fcastel2002/esc-bldc-sensorless-stm32/INFORME/README.md

# Informe y proyecto Overleaf

Esta carpeta contiene la documentacion tecnica del ESC BLDC sensorless con STM32.

## Archivos principales

- Paper/informe final en PDF: [ESC_Bldc___paper_congreso_utn___en_revision.pdf](ESC_Bldc___paper_congreso_utn___en_revision.pdf)
- Proyecto LaTeX/Overleaf: [ESC_Bldc___paper_congreso_utn___en_revision/](ESC_Bldc___paper_congreso_utn___en_revision/)
- Esquematico de deteccion ZC: [esquematico_zc.pdf](esquematico_zc.pdf)
- Esquematico alternativo ZC: [esquematico_2zc.pdf](esquematico_2zc.pdf)

## Imagenes destacadas

Maqueta final del prototipo

Diagrama conceptual

Circuito de cruces por cero
