fcastel2002/esc-bldc-sensorless-stm32/specs/templates/spec.md

# NNN Feature Name

Status: Draft

## Problem

Describe the user or system problem.

## Objective

Describe the outcome this feature must produce.

## Scope

In scope:

- Item 1.

Out of scope:

- Item 1.

## Affected Subprojects

- Firmware: Yes/No
- GUI/Bridge: Yes/No
- Protocol: Yes/No
- PIL/HIL/Simulink: Yes/No
- Docs/CI: Yes/No

## Protocol Impact

State whether frame layout, opcodes, constants, config semantics, telemetry, HID, UART, or UDP behavior changes.

## Acceptance Criteria

- Criterion 1.

## References

- Link to related docs, issues, or decisions.
