fcastel2002/esc-bldc-sensorless-stm32/INFORME/ESC_Bldc___paper_congreso_utn___en_revision.pdf

# Desarrollo de ESC para motores BLDC sin sensores de posicion, basado en ´ microcontrolador de la gama STM32

Francisco Castel
Facultad de Ingeniería - UNCUYO Mendoza, Argentina
castel.francisco@uncuyo.edu.ar https://github.com/fcastel2002

Abstract—Este trabajo presenta el desarrollo e
implementacion de un Controlador Electr ´ | onico de Ve- ´
locidad (ESC) sensorless para motores BLDC/PMSM utilizando microcontroladores STM32. El diseno se ˜ centra en un enfoque de bajo costo y complejidad reducida, basado en la deteccion de cruces por ´ cero (ZCP) de la fuerza contraelectromotriz mediante comparadores analogicos, complementado con ´ un control PI para la regulacion de velocidad. La ´ arquitectura propuesta aprovecha perifericos nativos ´ del STM32F103C8T6 (timers avanzados, ADC, UART y memoria Flash), lo que minimiza la carga computacional y aumenta la robustez del sistema. Se implemento una estrategia de arranque basada en ´
modulacion SPWM trif ´ | asica en lazo abierto, que ase- ´
gura una transicion estable hacia el r ´ | egimen ´ | sensor-
less. Asimismo, se desarrollo una m ´ | aquina de estados ´
modular que gestiona los distintos modos de operacion´ (IDLE, RUNNING, CLOSED-LOOP, CONFIG, entre otros), mejorando la escalabilidad y confiabilidad del firmware. Los ensayos experimentales con motores BLDC extraídos de discos rígidos demostraron un rango de operacion entre 100 y 5500 rpm, esta- ´ bilidad termica en la etapa de potencia basada en ´ L298N, y un control adecuado bajo condiciones de carga predecible. El prototipo constituye una base funcional para aplicaciones donde la simplicidad y la eficiencia prevalecen sobre la necesidad de control dinamico avanzado, tales como ventiladores, sistemas ´
de bombeo y pequenos veh ˜ | ículos electricos. Final- ´
mente, se discuten limitaciones del enfoque reactivo y posibles mejoras mediante tecnicas predictivas o ´ híbridas, apuntando hacia futuras implementaciones con mayor robustez e integracion industrial. ´
I. INTRODUCCION´

Los motores BLDC-PMSM (Brushless DC - Permanent Magnet Synchronous Motors) representan una tecnología fundamental en aplicaciones que requieren alta eficiencia y control preciso, desde
electrodomesticos hasta veh ´ | | ículos electricos y sis- ´
temas industriales. Su alta densidad de potencia, eficiencia superior (típicamente 85-95%) y mayor vida util los han convertido en la pieza fundamental ´ durante el desarrollo y evolucion de los drones, ´
donde la relacion potencia-peso es cr ´ | | ítica. Es por
esto que la motivacion principal de este trabajo es ´ la de entender profundamente el funcionamiento de este tipo de motores y las estrategias y tecnicas de ´ control del mismo.
Para lograr este objetivo se propuso la realizacion´ de un Controlador Electronico de Velocidad (ESC) ´ ya que prometía ser un desafio interesante y con ´ cierta complejidad.
La evolucion de las t ´ | ecnicas ´ | sensorless ha sido
notable desde que Iizuka et al. [1] propusieron
en 1985 un metodo basado en la detecci ´ | | on del ´
Zero Crossing Point (ZCP) mediante comparadores externos, estableciendo las bases para futuros desarrollos. Posteriormente, tecnicas como las descritas ´
por [2] mejoraron la precision mediante la medici ´ | on´
de BEMF durante la ventana de PWM OFF. Un avance significativo llego con Chen [3], quien ´ simplifico el ´ hardware necesario aprovechando el voltaje de línea, eliminando la necesidad de cir-

cuitos analogicos adicionales para el c ´ | alculo del ´
instante de conmutacion. ´
Actualmente, el Control de Campo Orientado (FOC) representa el estado del arte, ofreciendo control preciso de par y velocidad en un amplio rango operativo. Sin embargo, el FOC requiere algoritmos complejos que demandan mayor capacidad computacional y una medicion de corriente con ´ SNR superior a 40dB, lo que incrementa los costos de implementacion. ´
El objetivo del presente trabajo es proporcionar
un metodo sencillo y econ ´ | omico para el control ´
sensorless de motores BLDC/PMSM utilizando microcontroladores STM32. El enfoque se basa en la deteccion de cruces por cero mediante circuitos ´ analogicos simples, complementados con un control ´ PI para regular la velocidad. Esta implementacion´ aprovecha los perifericos del STM32F103C8T6 ´ (ADC, timer avanzados, etc) para minimizar la carga computacional, resultando ideal para aplicaciones de ventilacion y movimiento de aire donde ´ no se requiere control de posicion ni alto par de ´ arranque. El metodo es aplicable en sistemas de ´ baja y media potencia con velocidades mínimas de operacion superiores al 15-20% de la nominal. ´ Este documento esta organizado en secciones ´
que cubren: fundamentos teoricos del control ´ | sen-
sorless, diseno del hardware basado en STM32, ˜
implementacion del algoritmo de detecci ´ | on y con- ´
trol, resultados experimentales, y conclusiones con recomendaciones para trabajos futuros.
A. Principio de funcionamiento de motores BLDC
- PMSM

Cuando hablamos de motores sin escobillas, existen principalmente dos tipos, los motores con una BEMF trapezoidal, categorizados como BLDC, y los que presentan una BEMF sinusoidal, como PMSM. Ambos difieren de los motores DC con escobillas en que la conmutacion debe realizarse ´ de forma electronica, y no se realiza por la con- ´ struccion del mismo. Esta diferencia en la forma ´ de onda de la BEMF se debe principalmente a la
distribucion del bobinado y la configuraci ´ | on del ´
campo magnetico del rotor: los ´ | BLDC típicamente
utilizan bobinados concentrados y magnetizacion´ radial, mientras que los PMSM emplean bobinados distribuidos y, en muchos casos, magnetizacion´ sinusoidal.


Figure 1. Diferencia sustancial entre BLDC y PMSM

1) Metodos de detecci ´ | on de cruces por cero: ´ | La
deteccion de los cruces por cero (ZCP) de la ´ | | BEMF
constituye el metodo m ´ | as implementado para el ´
control sensorless de motores BLDC. Este punto ocurre cuando la BEMF cambia de polaridad, lo
que corresponde a una posicion espec ´ | ífica del rotor,
generalmente desfasada 30° electricos del punto ´
optimo de conmutaci ´ | on. ´
a) Deteccion directa de BEMF: ´ | | El metodo ´
clasico propuesto por Iizuka et al. [1] utiliza com- ´ paradores analogicos para detectar el instante en que ´ la BEMF cruza el nivel de referencia (generalmente el punto neutro virtual). Esta tecnica requiere cir- ´ cuitería de acondicionamiento para:
- Filtrar el ruido de conmutacion´
- Crear un punto neutro virtual para comparacion´
- Generar una senal de interrupci ˜ | on al microcon- ´
trolador
Mas adelante en el presente trabajo, se expresa la
eleccion de este m ´ | etodo. ´
b) Metodo de integraci ´ | on de la tercera ´
armonica: ´ | Esta tecnica, desarrollada por Moreira ´
en el 96’ [2], aprovecha el hecho de que la suma de las tres BEMF contiene una tercera armonica ´ significativa. La integracion de esta componente ´
proporciona informacion de posici ´ | on m ´ | as robusta ´
frente al ruido, aunque requiere un procesamiento adicional.

c) Metodo de terminal ´ | unico: ´ | Propuesto por
Chen et al. [3], este enfoque simplifica la implementacion hardware al utilizar solo un terminal ´
para la medicion de voltaje de l ´ | | ínea. La principal
ventaja es la reduccion de componentes externos y ´ la posibilidad de implementacion completa en mi- ´ crocontroladores con suficientes recursos de ADC.
d) Deteccion mediante PWM sincronizado: ´ Este metodo, particularmente adecuado para im- ´ plementaciones en microcontroladores, muestrea la BEMF durante los períodos de apagado del PWM, cuando la corriente de fase es mínima. La tecnica ´ requiere una sincronizacion precisa entre el PWM y ´ la secuencia de muestreo del ADC, factible en microcontroladores avanzados como la familia STM32 que ofrecen disparo sincronizado entre perifericos ´ [4].

II. ESQUEMA TECNOLOGICO ´

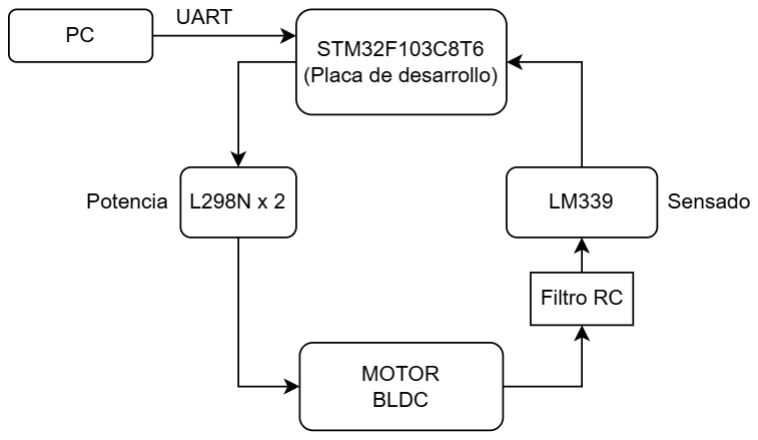
[picture p19: figure]

A. Detalle de modulos ´
1) Etapa de potencia: L298N: La etapa de po-
tencia se implemento utilizando dos m ´ | odulos basa- ´
dos en el circuito integrado L298N [5], configurados para proporcionar tres medios puentes H necesarios para la conmutacion trif ´ asica del motor ´ BLDC. Cada medio puente se controla mediante dos senales: una para el transistor superior y otra ˜ para el inferior. Este modulo presenta las siguientes ´ características:
- Voltaje de salida: 5V - 35V
- Voltaje logico: 5V - 7V ´
- Corriente maxima por canal: 2A ´
- Potencia maxima de disipaci ´ | on: 25W ´


Figure 2. Modulo comercial basado en L298N y sus respectivas ´ etapas de filtrado y feedback.

2) Motor utilizado: Para las pruebas se utilizaron dos motores sin escobillas sacados de discos rígidos antiguos, estos fueron una gran eleccion debido ´ a la alta disponibilidad como chatarra. No fue posible probar el sistema con motores BLDC de alto rendimiento como los presentes en drones comerciales. Así como estos motores son sencillos de conseguir, tambien es muy dificil de encontrar alguna referencia de ellos en internet ya que la
mayoria de codigos de referencia y/o n ´ | umeros, eran ´
mas bien codigos internos y no existen como tales, ´ por lo que no se consiguieron datos del motor como tal. Aunque un parametro que si era relevante para ´ saber si el algoritmo estaba funcionando de una forma adecuada era la velocidad maxima, y la de ´ los discos rígidos antiguos solía ser de no mas de ´ 5400 rpm, a diferencia de los actuales que llegan a las 7200 rpm.
Para que se nocion de la antig ´ | uedad de estos mo- ¨
tores, los discos duros de los que fueron extraídos usaban motores paso a paso para mover la aguja de lectura.


Figure 3. Motor extraido de un disco rígido antiguo

3) Circuito externo de deteccion: ´ Para la deteccion de cruces por cero de la fuerza ´ contraelectromotriz (BEMF), se implemento el ´ metodo propuesto por Iizuka [1], que utiliza ´
comparadores | analogicos | para | detectar | los ´
instantes en que la BEMF de la fase flotante cruza el nivel del punto neutro virtual. La fig:zerocrossing2muestraelcircuitoimplementado. En esta configuracion, las resistencias R4-R6 (10 ´ kΩ) crean un punto neutro virtual, lo que flexibiliza el tipo de bobinado de motor, ya que sea Estrella o Delta (acceso al neutro real o no) se utilizan solo las terminales de las tres fases. Luego las resistencias R1-R3 (10kΩ) y capacitores C1, C2 y C3 (47 nF) forman una etapa de filtrado para reducir el ruido de conmutacion y propio del motor. Los comparadores ´ del LM339 [6] detectan el momento exacto del cruce por cero (aun así se dota de histeresis me- ´ diante resistencias de 100 kΩ), generando flancos que son capturados por los canales de Input Capture (IC CH1, IC CH2 e IC CH3) del temporizador del microcontrolador.
Se selecciono el LM339 debido a su salida de ´ colector abierto, que permite una interfaz segura entre los 12V del circuito de potencia y los 3.3V del STM32F103C8T6, sin necesidad de circuitos adicionales de adaptacion de nivel. ´


Figure 4. Circuito implementado

Se decide la utilizacion de un comparador de ´ collector abierto como el LM339 [6] debido a su versatilidad al momento de interactuar con dispositivos de voltajes sumamente distintos al de alimentacion, como en este caso, 12V contra los ´ 3.3 V del STM32F103C8T6.

III. FUNCIONAMIENTO GENERAL

El objetivo principal del controlador es el de lograr la consigna de velocidad en el motor, para ello debe recibir los cruces por cero y a partir de ellos realizar las conmutaciones correspondientes. El funcionamiento del firmware en sí es sencillo, lo que hace es:
1) Rutina de arranque.
2) Realizar la conmutacion cuando se recibe el ´ flanco correspondiente desde el circuito comparador.
3) Medir el periodo entre dos flancos de subidas de una misma fase.
4) Cada cierto tiempo (regido por la velocidad maxima) actualizar la salida PWM mediante ´ un control PI.

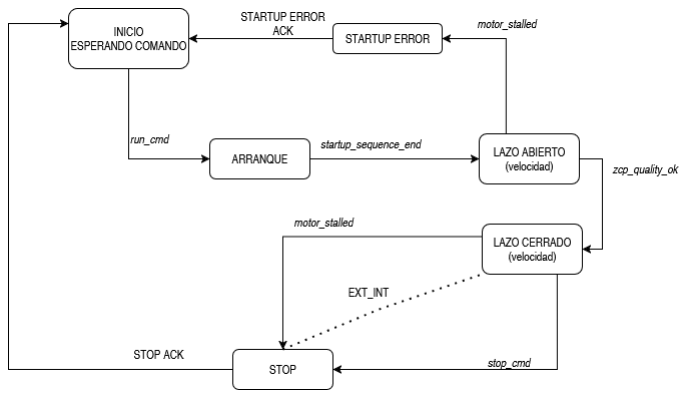
[picture p20: figure]

Pero esto no es suficiente para una conmutacion´ robusta, fue sumamente necesario incluir un algoritmo sencillo de deteccion de la consistencia de la ´ senal del cruce por cero. Esto es crucial para sobre ˜ todo el funcionamiento en lazo cerrado.

IV. PROGRAMACION´

A. Configuracion de perif ´ | ericos del microcontro- ´
lador
El microcontrolador STM32F103C8T6 se con-
figuro para realizar tanto la detecci ´ | on de cruces por ´

cero como la generacion de se ´ | nales de control para ˜
los puentes H:
- timer 2: Configurado con tres canales en modo Input Capture para detectar los flancos provenientes de los comparadores. Este enfoque, en lugar de utilizar interrupciones externas (EXTI), permite medir directamente el período entre cruces por cero, facilitando el calculo ´ de la velocidad del motor y la temporizacion´ precisa de la conmutacion. ´
- timer 1: Utilizado como generador PWM para controlar los transistores superiores de los medios puentes. Se configuro para operar en un ´ rango de frecuencias entre 10 y 24 kHz (no fue necesaria la implementacion de tiempo muerto ´ dado que el retraso propio de la conmutacion´ proporciona una especie de dead time).
- UART1: Periferico UART configurado a ´ 115200 de baudrate utilizado en modo interrupcion. ´
- CRC: Periferico utilizado para la verificaci ´ | on´
de integridad de datos. Este modulo permite ´
realizar calculos r ´ | apidos de verificaci ´ | on, con- ´
tribuyendo a la robustez en la transmision´
y almacenamiento de parametros cr ´ | íticos, se
utiliza para la persistencia de parametros en ´ FLASH.
- Memoria Flash: Utilizada para almace-
namiento no volatil de par ´ | | ametros de config- ´
uracion y calibraci ´ | on del ESC. La memoria ´
Flash permite conservar configuraciones esenciales entre reinicios o ciclos de alimentacion. ´ Permite al operario configurar su ESC como desee.
1) Senales PWM: ˜ | La tecnica PWM seleccionada ´
corresponde a ”PWM technique 1” en la fig:pwmtech, tambien conocida como PWM unipolar. En ´ esta configuracion, durante cada sector de 60° ´ electricos, una fase se conecta al positivo mediante ´ PWM, otra fase se conecta al negativo de forma permanente, y la tercera fase permanece flotante
(desconectada). Se eligio esta t ´ | ecnica ya que la ´
implementacion de las dem ´ | as t ´ | ecnicas, seg ´ | un Lai ´
et al en [7], pueden cobrar sentido si se utiliza un metodo de sensado directo de la BEMF mediante ´ ADC.

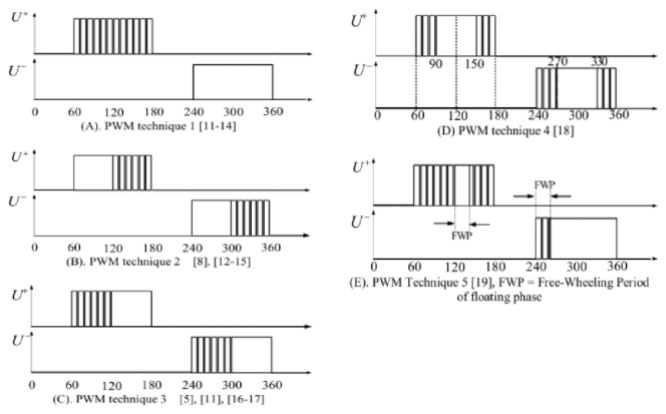
[picture p21: figure]

Figure 5. Resumen de tecnicas PWM para motores BLDCM. ´ [7]

B. Estrategia de arranque
El arranque representa uno de los mayores desafíos en el control sensorless de motores BLDC, ya que a velocidad cero o muy baja no se genera suficiente BEMF para detectar la posicion del rotor. ´ En este trabajo se evaluaron diferentes estrategias de arranque antes de seleccionar la implementacion´ final.
1) Alternativas consideradas: La tecnica ´ | Align
& Go, ampliamente documentada en la literatura, fue inicialmente considerada debido a su simplici-
dad de implementacion. Sin embargo, esta t ´ | | ecnica ´
presenta una desventaja significativa: la posibilidad de que el rotor inicie su movimiento en direccion´ opuesta a la deseada. Si bien existen algoritmos para detectar y corregir esta situacion, su imple- ´
mentacion requiere una detecci ´ | on casi instant ´ | anea ´
del sentido de rotacion y una r ´ | apida inversi ´ | on de ´
la secuencia de conmutacion, aumentando consid- ´ erablemente la complejidad del sistema.
Otra alternativa analizada fue el metodo IPD ´ (Initial Position Detection), implementado por Meghana et al en [8], que permite un arranque desde velocidad cero mediante la deteccion de la ´
posicion inicial del rotor. A pesar de ser el m ´ | | etodo ´
mas utilizado en aplicaciones comerciales de con- ´ trol sensorless, la complejidad de sus algoritmos y los requisitos de sincronizacion precisa entre ´ perifericos lo situaron fuera del alcance de este ´ trabajo.
2) Solucion implementada: SPWM en la etapa ´ de arranque: La estrategia de arranque adoptada se basa en un generador senoidal de tres fases mediante modulacion por ancho de pulso senoidal ´ (SPWM), implementado completamente en lazo abierto. Esta tecnica consiste en: ´
1) Precalculo de tres tablas senoidales desfasadas ´
120° electricos entre s ´ | í (una por fase), ajus-
tadas al formato Q15 y escaladas para facilitar su modulacion en tiempo real. ´
2) Generacion peri ´ odica de valores PWM actual- ´ izados a partir de dichas tablas, mediante un temporizador auxiliar que actualiza el índice de fase a intervalos controlados.
3) Aplicacion de estas se ´ | nales al puente inversor ˜
trifasico del motor, con habilitaci ´ | on de las tres ´
fases y control de flotacion durante toda la ´ etapa de arranque.
4) Incremento controlado de la frecuencia efec-
tiva del campo rotante a traves de la reducci ´ | on´
progresiva del ARR (Auto-Reload Register) del temporizador auxiliar.
5) Aumento gradual del valor de modulacion´ (mod_q15), que controla la amplitud de la senal aplicada, desde un valor inicial bajo ˜ (≈ 20%) hasta una amplitud estable cercana al 100%.
6) Finalizacion | autom ´ | atica | del | arranque ´
tras | un | numero | fijo | de | iteraciones ´
(STARTUP_ITERATIONS), | momento | en
el cual se realiza la transicion controlada al ´
modo de conmutacion trapezoidal ´ | sensorless.

La logica de control se implementa utilizando el ´ temporizador TIM4 del STM32F103C8T6 para las actualizaciones periodicas de PWM, mientras que ´ el generador de PWM (TIM1) continua modulando la senal SPWM. Durante el arranque, el sistema no ˜ requiere retroalimentacion alguna del motor: no se ´
evalua la ´ | BEMF, ni se mide corriente, ni se utiliza
informacion de posici ´ | | on. ´
La transicion al modo de operaci ´ | on´ sensorless
se realiza de forma determinista, tras agotar el tiempo definido para el arranque. En ese instante, se detiene la modulacion SPWM, se deshabilitan mo- ´ mentaneamente las salidas, y se reinicializa el sis- ´ tema para comenzar con la conmutacion trapezoidal ´ convencional, habilitando el sistema de deteccion de ´ cruces por cero.
3) Ventajas y limitaciones: Esta aproximacion´ presenta varias ventajas relevantes para la aplicacion: ´
- Permite un arranque suave y robusto, incluso
en ausencia total de informacion de posici ´ | on o ´
velocidad.
- Es insensible a la posicion inicial del rotor, ´ gracias a la naturaleza continua del campo magnetico rotante generado. ´
- Su implementacion es simple y determinista: ´ no requiere ajustes dinamicos durante el ar- ´
ranque, ni evaluacion de condiciones de ´ | exito ´
o fallo.
Como limitacion principal, el sistema no es capaz ´ de detectar si el motor ha sincronizado efectivamente durante la etapa de arranque. El metodo ´ asume que, al finalizar el tiempo definido, el rotor
habra sido capaz de seguir el campo magn ´ | etico ´
generado. Esto representa un riesgo en condiciones de carga elevada o con el rotor bloqueado, ya que la transicion podr ´ ía realizarse sin que el motor haya adquirido velocidad efectiva.
Cabe destacar, sin embargo, que si bien durante el arranque no se evalua la consistencia de los cruces ´
por cero debido a que la senal de ˜ | BEMF queda
enmascarada por la modulacion senoidal (haciendo ´ que cualquier cruce detectado en esta etapa sea irrelevante o espurio), el sistema implementa una verificacion posterior. Tras completarse el tiempo de ´ arranque y al entrar al modo sensorless, si los cruces por cero detectados no presentan la coherencia esperada, se considera fallida la sincronizacion y ´ se vuelve automaticamente a ejecutar la maniobra ´ de arranque desde cero. Esta estrategia anade una ˜ capa de robustez frente a condiciones anomalas sin ´ complejizar la logica de control durante el arranque ´ propiamente dicho.
C. Conmutacion´
Para conmutacion de las fases, se optan dos es- ´ trategias cruciales para no perder la sincronizacion´ tan buscada desde la etapa de arranque entre los cruces por cero, la posicion del rotor y los pasos de ´ la conmutacion. ´
1) Fase flotante como variable global: Un problema que surgía al momento de utilizar el metodo ´

de Iizuka es que si no se asignaba un orden de prioridad a las interrupciones era factible que uno de los canales detectara una segunda interrupcion´ antes de que el canal de la fase que nos interesa (la fase flotante) detectase su flanco, provocando esto una conmutacion a destiempo. Por esto se deciden ´ crear tres variables booleanas (float U; float V y float W) que se encargan de informar al callbak de interrupciones de cual sera la pr ´ oxima fase flotante, ´ es decir, el proximo canal que debe atender. Por ´ ejemplo, para el paso de conmutacion que energiza ´ las fases U y V (+U -V) el trio de variables tomaría los siguientes valores:
- float U = false
- float V = false
- float W = true
Agregando así un condicional adicional al callback de interrupcion. ´
2) Alternado de polaridad del input capture: Un factor indispensable a tener en cuenta durante el desarrollo de la conmutacion fue el de la necesidad ´ de que los canales del input capture correspondientes a cada fase pudiesen captar tanto flancos de bajada como de subida, lamentablemente esto no esta permitido para el canal 3 del timer 1 (aun siendo este un timer avanzado) por lo que este inconveniente se soluciono cambiando la polaridad de cada canal de forma alternada, es decir que, por ejemplo, el canal que corresponde a la fase U, para la primer posicion dentro de la secuencia se establece con polaridad de flanco de bajada, y luego para el proximo paso donde la fase U es flotante, se establece la polaridad de flanco de subida, esto
se repetira para cada canal. Esta implementaci ´ | on no ´
solo soluciono las incapacidades del ´ | timer 1, si no
que propuso mas robustez al sistema previniendolo ´ de falsos cruces por cero dados por posible ruido, así, es imposible que un flanco de bajada sea detectado previo a otro flanco de bajada del mismo canal.
D. Sistema de maquina de estados ´

La maquina de estados constituye la columna ver- ´ tebral del controlador, gestionando las transiciones entre los diferentes modos de operacion. ´

Table I
SECUENCIA DE CONMUTACION DE ´ | 6 PASOS PARA MOTOR
BLDC
2*Paso | Enable | PWM | 2*Polaridad | Flotantes
| U V W | U V W | | U V W
POS UV POS UW POS VW POS VU POS WU POS WV | 1 1 0 1 0 1 0 1 1 1 1 0 1 0 1 0 1 1 | PWM 0 -PWM -0 -PWM 0 0 PWM -0 -PWM -0 PWM | Fall(CH1) Rise(CH3) Fall(CH2) Rise(CH1) Fall(CH3) Rise(CH2) | No No Sí No Sí No Sí No No No No Sí No Sí No Sí No No
La funcion´ | handleState() implementa un
patron de dise ´ | no basado en estados que permite: ˜
- Separar claramente la logica para cada modo ´
| de operacion´
- Gestionar transiciones controladas entre esta-
| dos
- Mantener activas solo las interrupciones necesarias en cada estado
V. RESUMEN DEL FUNCIONAMIENTO DE LA
| MAQUINA DE ESTADOS ´
El | modulo | de | la | m ´ | aquina | de | estados ´
(‘state machine.c‘) | implementa | el | control
centralizado del ESC mediante una estructura clara y robusta basada en estados. Las funciones y características principales son:
- handleState(): Gestiona la transicion entre es- ´ tados, procesando eventos internos y externos, asegurando una ejecucion ordenada y segura ´
| del ESC.
- Estados clave:
– IDLE: Estado inicial o de espera sin actividad del motor.
– PROCESS COMMAND: Procesa comandos recibidos desde el modulo de comuni- ´
| cacion. ´
– FOC STARTUP: Maneja la secuencia inicial de arranque.
– RUNNING: Estado operativo basico, ges- ´ tionando velocidad abierta.
– CLOSEDLOOP: Control operativo avanzado con ajuste automatico por reali- ´
| mentacion. ´
– CONFIG: | Realiza | configuraciones
recibidas por comandos externos.

– READY: Preparacion intermedia para el ´ control de lazo cerrado.
– STOPPED: Estado de detencion del motor. ´ – FINISH: Finaliza operaciones y retorna a IDLE.
– HARD ERROR: | Manejo | de | errores
críticos que requieren intervencion. ´
La maquina de estados garantiza un control ro- ´ busto, previniendo errores críticos mediante transi-
ciones claras y supervisadas, y actua como n ´ | ucleo ´
central que coordina la interaccion y comunicaci ´ | on´
efectiva entre todos los modulos del sistema. Su ´ estructura es facilmente escalable, facilitando la ´
incorporacion de nuevos estados y eventos seg ´ | | | un´
sea necesario.
A. Funciones mas importantes del control
- commutation()
Controla | la | secuencia | de | acti-
vacion/desactivaci ´ | on de las fases U, V, y ´
W del motor brushless segun el paso actual ´ de conmutacion. ´
Establece las polaridades adecuadas y asigna valores PWM específicos a cada fase segun la ´ posicion del rotor. ´
- zero crossing()
Gestiona el control del motor mediante la
deteccion de cruces por cero ( ´ | Zero Crossing
Points - ZCP).
Realiza la conmutacion del motor en cada ´ cruce por cero detectado en cualquiera de las fases.
Actualiza la velocidad usando mediciones trifase para calcular un promedio por consenso entre las fases (metodo robusto). ´
- pi control()
Implementa un controlador Proporcional-Integral (PI) para ajustar el PWM del motor segun un setpoint de velocidad. ´
Utiliza parametros configurables (KP, KI) para ´ el control fino de la velocidad y limita la salida PWM dentro de rangos seguros.
- check motor status()
Monitorea periodicamente el estado operativo ´ del motor.

Detecta condiciones de bloqueo (stall) mediante la comprobacion de tiempo desde el ´
ultimo cruce por cero v ´ | alido. Establece una ´
bandera (motor stalled) para indicar situaciones críticas.
- stop motor()
Maneja el procedimiento para detener el motor en dos modos:
Detencion gradual (modo normal). ´
Detencion inmediata de emergencia (modo ´ crítico), con cambio de direccion temporal para ´ frenado rapido. ´
- calculate consensus speed()
Calcula la velocidad promedio por consenso utilizando mediciones consistentes de multiples fases, lo que mejora significativa- ´ mente la robustez ante ruidos o fallos ocasionales en la deteccion de cruces por cero. ´
B. Sistema de comunicacion´

El controlador implementa un protocolo de co-
municacion basado en comandos textuales a trav ´ | es´
de UART, permitiendo la configuracion y monitor- ´ izacion del sistema. ´
1) Resumen del funcionamiento de la comuni-
cacion: ´ | El modulo de comunicaci ´ | on (‘comm.c‘) ´
implementa la interfaz UART para interaccion ex- ´ terna con el ESC. Las funciones mas importantes ´ son:
- commInit(): Inicializa el buffer de recepcion y ´
comienza la recepcion por interrupci ´ | on usando ´
UART.
- processUartData(): Lee y procesa bytes recibidos del buffer circular. Detecta comandos completos al recibir caracteres finales como \r
o \n, almacenandolos para su ejecuci ´ | on. ´
- processCommand(): | Analiza | comandos
recibidos, | los | valida | sintacticamente | y ´
determina la accion a realizar, pudiendo ´
ejecutar | acciones | como | RUN, | STOP,
EMERGENCY STOP o ajustes específicos como la frecuencia PWM.
- executeCommand(): Ejecuta la accion indi- ´ cada en el comando analizado (por ejemplo, configurar la frecuencia PWM o iniciar la maniobra de arranque FOC), devolviendo un estado de confirmacion. ´
- transmitirUART(): Envía respuestas por UART usando transmisiones no bloqueantes por interrupcion, informando estados o errores ´ al usuario externo.
Este modulo asegura una comunicaci ´ | on robusta ´
y eficiente con la interfaz externa, permitiendo el control dinamico del ESC mediante comandos ´
estructurados. Ademas, su dise ´ | no es altamente es- ˜
calable, ya que permite facilmente la incorporaci ´ | on´
de nuevas acciones y parametros para extender o ´ adaptar el conjunto de comandos disponibles.

VI. ETAPAS DE MONTAJE Y ENSAYOS

REALIZADOS

En esta seccion se describen las principales eta- ´ pas del montaje del sistema ESC y los ensayos efectuados para verificar su funcionamiento.

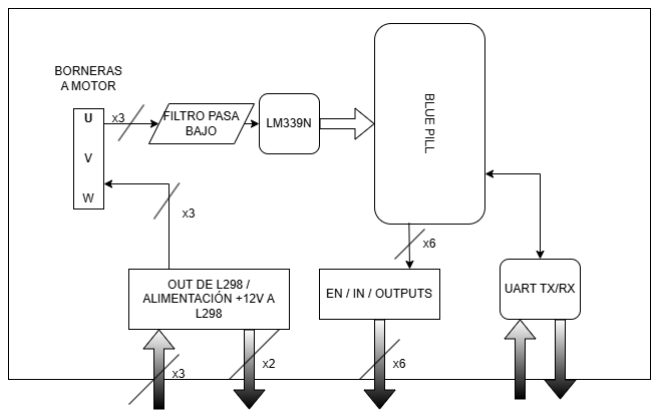
[picture p22: figure]

Figure 6. Esquematico conceptual de conexiones y partes del ´ prototipo

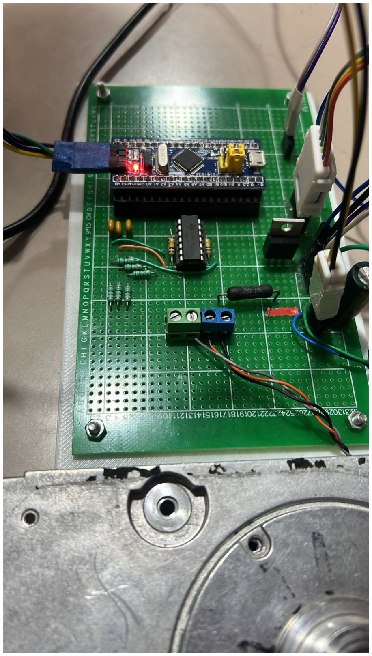
[picture p23: figure]

Figure 7. Montaje del circuito logico en la placa de prototipado. ´

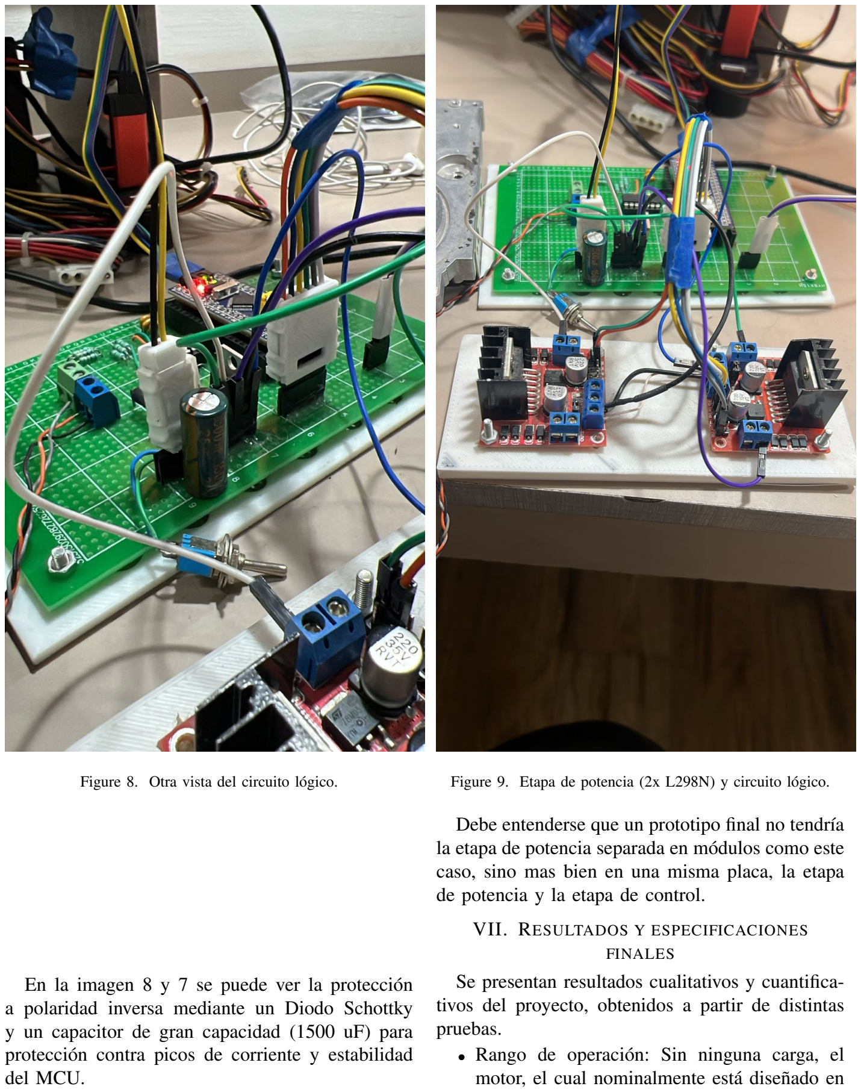
[picture p24: page 10]

Figure 8. Otra vista del circuito logico. ´

En la imagen 8 y 7 se puede ver la proteccion´ a polaridad inversa mediante un Diodo Schottky y un capacitor de gran capacidad (1500 uF) para proteccion contra picos de corriente y estabilidad ´ del MCU.

Figure 9. Etapa de potencia (2x L298N) y circuito logico. ´

Debe entenderse que un prototipo final no tendría la etapa de potencia separada en modulos como este ´ caso, sino mas bien en una misma placa, la etapa de potencia y la etapa de control.

VII. RESULTADOS Y ESPECIFICACIONES

FINALES
Se presentan resultados cualitativos y cuantificativos del proyecto, obtenidos a partir de distintas pruebas.
- Rango de operacion: Sin ninguna carga, el ´ motor, el cual nominalmente esta dise ´ nado en ˜

5400 rpm, segun las lecturas del osciloscopio ´ muestra una velocidad maxima de 5500 rpm, ´ y una velocidad mínima de 100 rpm.
- La etapa de potencia no presenta disipacion´ termica notable, con los disipadores presentes ´
en los modulos L298, en t ´ | erminos generales, ´
por lo mencionado, la temperatura de los mosfets no supera los 40°C.
- Limitante principal y proximo paso a mejo- ´ rar: El hecho de que el sistema sea reactivo, y no predictivo, produce un comportamiento esperable, que no se puede confiar ciegamente en las lecturas de cruces por cero, por lo que es muy sensible a una desincronizacion. Se ´ mejoraría este aspecto logrando un metodo ´ predictivo, pero se soluciona por completo el enmascaramiento de la senal del cruce por cero ˜ tomando un enfoque de lectura de corrientes, sin entrar en algoritmo FOC.
- Control pobre en terminos generales: No es ´ posible realizar cambios bruscos de velocidad, ya que estos generan picos de corriente en la senal que distorsionan por completo la lectura ˜ de los cruces por cero, y debido a la naturaleza reactiva de estos, el control pierde sentido. Una
solucion muy interesante e investigada podr ´ | | ía
ser la implementacion de control difuso para ´ estas consignas de velocidad bruscas.

VIII. CONCLUSIONES. ENSAYO DE INGENIERÍA

| DE PRODUCTO

Aplicabilidad del sistema

Si bien el ESC no esta dise ´ | nado para aplicaciones ˜
que requieran precision din ´ | amica elevada o control ´
activo de par, resulta especialmente adecuado para sistemas donde el control de velocidad sea el requerimiento principal y las condiciones de carga se mantengan dentro de margenes predecibles. ´
Entre las aplicaciones posibles se incluyen:
- Sistemas de bombeo de agua o fluidos industriales.
- Ventiladores centrífugos o axiales de media y baja potencia.
- Propulsion de peque ´ | nos drones o veh ˜ | ículos
autonomos. ´
- Sistemas de refrigeracion, circulaci ´ | on y clima- ´
tizacion. ´
Analisis detallado: bomba centr ´ | ífuga de agua

Para validar mas rigurosamente la viabilidad del ´ controlador en una aplicacion real, se analiza su de- ´ sempeno esperado en el contexto del accionamiento ˜ de una bomba centrífuga.
Este tipo de carga presenta un perfil de par creciente con la velocidad, típicamente proporcional al cuadrado de la misma (T ∝ ω

2
). Ademas, ´
las variaciones de carga durante el funcionamiento son suaves, lo que reduce las exigencias dinamicas ´ del sistema de control. Asimismo, no se requiere
inversion del sentido de giro ni regulaci ´ | on precisa ´
del par instantaneo. ´
El ESC desarrollado cumple con los requerim-
ientos basicos de esta aplicaci ´ | on: ´
- Arranque suave: la rampa de frecuencia en modo SPWM permite una aceleracion gradual, ´ limitando los picos de corriente sin necesidad de sensado.
- Control de velocidad estable: tras el arranque, el sistema opera en lazo abierto con conmutacion sincronizada a los cruces por ´ cero, ofreciendo estabilidad suficiente en aplicaciones con dinamica lenta, como una bomba ´ hidraulica. ´
- Proteccion frente a bloqueo: ´ | el firmware
implementa un mecanismo de deteccion de ´
perdida de sincron ´ | ía mediante el monitoreo
de cruces por cero. Ante inconsistencias sostenidas, el sistema reinicia la secuencia de arranque o detiene la conmutacion, funcio- ´ nando como una proteccion frente a bloqueo ´ mecanico. ´
- Compatibilidad con el entorno operativo: la topología sin sensores y el bajo numero ´ de componentes electronicos favorecen la inte- ´
gracion del controlador en entornos h ´ | umedos ´
o de difícil acceso, donde la robustez y el bajo mantenimiento son prioridades.

Seleccion final de componentes y esquema de pro- ´ teccion´

### 1. Motor de aplicacion´

- Tipo: Brushless trifasico ´ sensorless, 12– 24 V.
- Ejemplo comercial: Turnigy D2830/11 1000 KV (100 W continuo @ 12–14.8 V, Imax ≈ 10 A).

### 2. Etapa de potencia

- MOSFETs: 6× IRLZ44N (55 V, 47 A, RDS(on) ≤ 22 mΩ). Montados sobre disi-
pador comun de aluminio (R ´ | θSA ≤ 2 °C/W).
- Driver: 3× IR2101S (medio-puente alto/bajo, con bootstrap). VHB ≤ 600 V – sobredimensionado para 24 V. Capacidad de corriente de puerta: ±2 A (tiempo típico de carga ≈ 150 ns para Qg ≈ 100 nC).
- Resistores de puerta: Rg = 10–12 Ω para amortiguacion de ´ ringing.

### 3. Controlador principal

- STM32F103C8T6 (Cortex-M3, 72 MHz), validado en el prototipo.
- Oscilador externo de 8 MHz tipo HC-49S para mayor precision temporal (PWM y ´ captura).

### 4. Fuente y filtro de entrada (24 V DC)

- Fuente conmutada industrial 24 V / 6 A (Mean Well LRS-150-24 o equivalente).
5. Proteccion y aislamiento de se ´ | nales ˜
- Para proteger el microcontrolador y reducir los efectos de perturbaciones electricas gen- ´ eradas durante la conmutacion o prove- ´ nientes de la red de alimentacion, se re- ´ comienda incorporar aislamiento entre la etapa de control y la etapa de potencia. Esto puede lograrse mediante optoacopladores
rapidos, especialmente en las se ´ | nales que ˜
activan los drivers de compuerta.
- La inclusion de filtros pasivos (como re- ´ des RC o snubbers) en las fases de salida puede ayudar a atenuar transitorios generados durante los cambios de estado de los MOSFETs. Estos elementos tambien pueden ´ reducir la emision de interferencias electro- ´ magneticas hacia otros dispositivos sensi- ´ bles.
- En la entrada de alimentacion, es aconse- ´ jable emplear un filtro de tipo Pi o similar, con inductores y capacitores adecuados a la corriente del sistema, para minimizar los efectos de ruido conducido, tanto emitido como recibido.
- Adicionalmente, la inclusion de un sensor de ´ temperatura sobre el disipador de los MOS-FETs permitiría implementar una logica de ´ proteccion t ´ ermica, deteniendo el sistema ´ ante un sobrecalentamiento prolongado.

En conclusion, el prototipo desarrollado consti- ´ tuye una base funcional para un ESC sensorless de bajo costo. Sin embargo, su viabilidad industrial requiere una reingeniería de la etapa de potencia, mejoras en el firmware y una seleccion cuidadosa de ´ componentes que permitan aumentar su eficiencia, confiabilidad y adaptabilidad a entornos reales. Se provee del link al repositorio. https://github.com/fcastel2002/esc-bldc-sensorless-stm32 (https://github.com/fcastel2002/esc-bldc-sensorless-stm32)

REFERENCES

[1] K. Iizuka, H. Uzuhashi, M. Kano, T. Endo, and K. Mohri, “Microcomputer control for sensorless brushless motor,” IEEE Transactions on Industry Applications, vol. IA-21, no. 3, p. 595–601, May 1985. [Online]. Available: http://dx.doi.org/10.1109/TIA.1985.349715
[2] J. Moreira, “Indirect sensing for rotor flux position of permanent magnet ac motors operating over a wide speed range,” IEEE Transactions on Industry Applications, vol. 32, no. 6, p. 1394–1401, 1996. [Online]. Available: http://dx.doi.org/10.1109/28.556643
[3] S.-H. Chen, T.-H. Liu, and F.-C. Hsiao, “Sensorless control of the bldc motors using a kalman filter,” in 2007 International Conference on Machine Learning and Cybernetics, vol. 4, 2007, pp. 1934–1939.
[4] STMicroelectronics, | RM0008 | Reference | Manual:
STM32F101xx, | STM32F102xx, | STM32F103xx,
STM32F105xx | and | STM32F107xx | advanced | ARM-
based | 32-bit | MCUs, | STMicroelectronics, | Geneva,
Switzerland, August 2021, rev 21. [Online]. Available:
https://www.st.com/resource/en/reference manual/ rm0008-stm32f101xx-stm32f102xx-stm32f103xx-stm32f105xx-and-stm32f107xx-advanced-armbased-32bit-mcus-stmicroelectronics. pdf (https://www.st.com/resource/en/reference_manual/rm0008-stm32f101xx-stm32f102xx-stm32f103xx-stm32f105xx-and-stm32f107xx-advanced-armbased-32bit-mcus-stmicroele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)
[5] STMicroelectronics, L298N Dual Full-Bridge Driver, 2023.
[6] Texas Instruments, LM339, LM239, LM139, LM2901 Quad
Differential Comparators, Texas Instruments Incorporated, July 2022, sLCS006AA - Revised July 2022. [Online]. Available: https://www.ti.com/lit/ds/symlink/lm339-n.pdf
[7] Y.-S. Lai and Y.-K. Lin, “A unified approach to zero-crossing point detection of back emf for brushless dc motor drives without current and hall sensors,” IEEE Transactions on Power Electronics, vol. 26, no. 6, pp. 1704–1713, 2011.
[8] R. Meghana and R. R. Singh, “Sensorless start-up control for bldc motor using initial position detection technique,” in 2020 IEEE International Conference on Power Electronics, Smart Grid and Renewable Energy (PESGRE2020). IEEE, Jan. 2020. [Online]. Available: http://dx.doi.org/10.1109/PESGRE45664.2020.9070409
