fcastel2002/esc-bldc-sensorless-stm32/tf_control_y_sistemas/Anteproyecto_TF_CyS_2026_CASTEL_13784.pdf

# Trabajo Final

### Agitador magnético con control de agitación frente a variaciones de viscosidad

### Francisco Castel Facultad de Ingeniería – Universidad Nacional de Cuyo Control y Sistemas

### 6 de junio de 2026

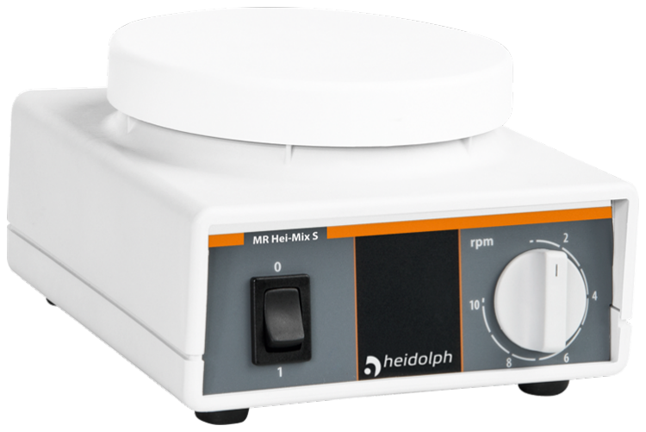
[picture p25: figure]

Figura 1: Agitador comercial Hei-Mix S. Fuente: https://heidolph.com/asia/en/hei-mix-s~p345 (https://heidolph.com/asia/en/hei-mix-s~p345)

## 1. Propuesta y motivación

Se propone desarrollar un agitador magnético de laboratorio accionado por un motor BLDC/PMSM. El motor hará girar un imán permanente ubicado debajo del recipiente y, mediante acoplamiento magnético, transmitirá movimiento a una barra agitadora inmersa en el fluido.
La aplicación resulta de interés porque la carga mecánica del sistema no es fija: depende de la viscosidad del fluido, el volumen, la geometría del recipiente, el tamaño de la barra y la calidad del acoplamiento magnético. En esas condiciones, un ajuste manual de potencia puede ser insuficiente si se busca repetibilidad entre ensayos o una condición de mezcla estable.
Desde el punto de vista práctico, la agitación magnética permite mezclar fluidos sin introducir un eje mecánico en el recipiente, lo que simplifica el uso con muestras y recipientes intercambiables. Desde el punto de vista académico, el sistema combina accionamiento eléctrico, sensado, carga variable y control discreto en una aplicación concreta, acotada y vinculada con la maqueta previa de motores BLDC/PMSM. Link del repositorio al trabajo, puede verse la arquitectura de la maqueta y la estrategia de control tomada: https://github.com/fcastel2002/esc-bldc-sensorless-stm32

## 2. Objetivo

Diseñar y validar un sistema de control para un agitador magnético capaz de mantener una condición de agitación estable frente a variaciones de carga asociadas principalmente a cambios de viscosidad del fluido.
Los objetivos específicos son:

Definir la arquitectura general del agitador: motor, accionamiento, imán impulsor, barra agitadora, recipiente y fluido.

Analizar la reutilización de la maqueta previa del ESC para motores BLDC/PMSM.

Plantear una representación de alto nivel que relacione accionamiento, agitación y carga viscosa.

Proponer una estrategia de control de velocidad o intensidad de agitación.

Validar por simulación el comportamiento ante cambios de consigna, variaciones de carga y perturbaciones representativas.

## 3. Sistema propuesto

La planta puede entenderse como una cadena de conversión entre la acción eléctrica aplicada al motor y el movimiento final del fluido:

accionamiento eléctrico → motor → imán impulsor → barra agitadora → fluido.

La variable controlada inicial será la velocidad del motor o una magnitud equivalente asociada a la intensidad de agitación. La perturbación principal será la variación de carga producida por cambios de viscosidad. También se considerarán efectos como pérdida parcial de acoplamiento, descentrado de la barra, variaciones de volumen y limitaciones propias de la etapa de potencia.

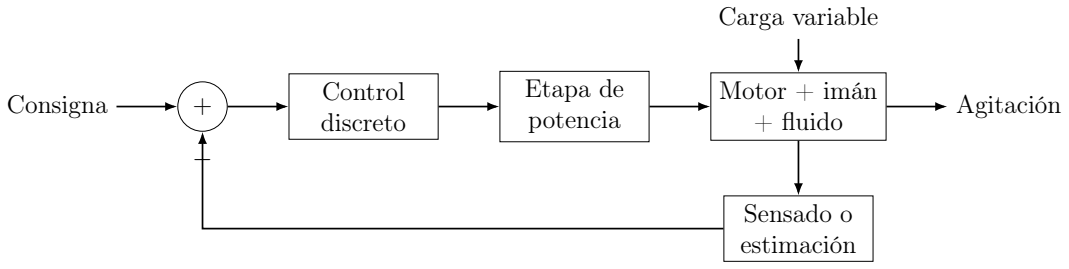
[picture p26: figure]
Consigna; Control discreto; Etapa de potencia; Motor + imán + fluido; Sensado o estimación; Agitación; Carga variable

Figura 2: Diagrama conceptual del sistema de control.

## 4. Control, sensado y validación

La estrategia de control se definirá a partir de una referencia indicada por el usuario, una medición o estimación de la salida y una acción sobre el motor. La maqueta previa servirá como punto de partida para reutilizar, si resulta conveniente, la etapa de potencia, la generación de PWM, las rutinas de arranque y la medición o estimación de velocidad del motor.
La elección de sensores quedará asociada a la información necesaria para cerrar el lazo. En principio se evaluará si alcanza con estimar la velocidad del motor o si conviene incorporar medición de corriente, sensores externos o alguna forma de detección de desacople entre el imán impulsor y la barra agitadora.
La validación se realizará mediante simulaciones y, si la maqueta lo permite, ensayos de alcance limitado. Se considerarán cambios de consigna, variaciones equivalentes de viscosidad, pérdida parcial de acoplamiento, ruido de medición y saturación del accionamiento. Los criterios principales serán estabilidad, capacidad de sostener la agitación, esfuerzo de control y factibilidad de implementación.

## 5. Puntos pendientes

Durante el desarrollo deberán resolverse las siguientes decisiones:

Determinar si alcanza con controlar la velocidad del motor o si debe medirse alguna variable más cercana a la agitación real.

Definir si será necesario sensar corrientes de fase o de bus para estimar carga, detectar desacople o proteger la etapa de potencia.

Evaluar si la conmutación actual es suficiente o si conviene migrar hacia un método basado en corrientes.

Establecer el rango de viscosidades, volúmenes y velocidades que se tomará como caso de estudio.

Definir qué parte se validará por simulación y qué parte podrá verificarse experimentalmente.

## 6. Resultado esperado

Se espera obtener una propuesta técnicamente justificada de agitador magnético controlado, apoyada en la maqueta existente y validada mediante simulaciones o ensayos acotados.

El resultado deberá mostrar que la aplicación es viable y que el control propuesto mejora la capacidad de mantener una condición de agitación frente a cambios razonables de carga.
