fcastel2002/esc-bldc-sensorless-stm32/specs/templates/design.md

# NNN Feature Design

## Summary

Describe the selected implementation approach.

## Current Behavior

Describe the relevant existing system behavior.

## Proposed Behavior

Describe the new behavior and ownership boundaries.

## Data And Protocol

Describe data structures, payloads, opcodes, state transitions, and compatibility notes.

## Alternatives Considered

- Alternative: reason it was not selected.

## Risks

- Risk and mitigation.
