fcastel2002/esc-bldc-sensorless-stm32/tf_control_y_sistemas/BaseConocimiento/dsp.pdf

## 2.A. Etapas esenciales de un sistema DSP

Dr. Ing. Hernán Garrido

Control y sistemas
Universidad Nacional de Cuyo, Facultad de Ingeniería

carloshernangarrido@gmail.com

Noviembre de 2023

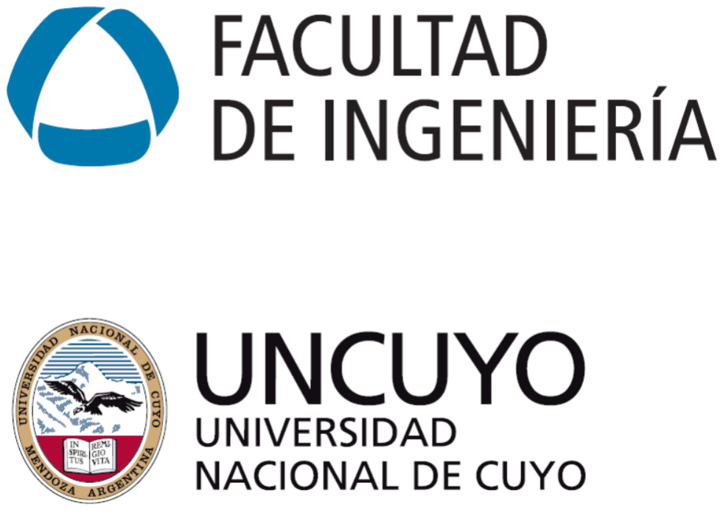
[picture p45: figure]

Dr. Ing. Hernán Garrido (FING-UNCUYO) | DSP | Noviembre de 2023 | 1 / 34

## Contenidos

1 | Introducción
2 | Filtro antialiasing
3 | Técnica de oversampling
4 | Conversión A/D
5 | Error de cuantización
6 | Relación señal-ruido de un conversor A/D y su relación con la cantidad de bits
7 | Conversión D/A
8 | Técnicas de upsampling, pre-ecualización y post-ecualización
Dr. Ing. Hernán Garrido (FING-UNCUYO) | DSP | Noviembre de 2023 | 2 / 34

## DSP en el contexto de los sistemas de control

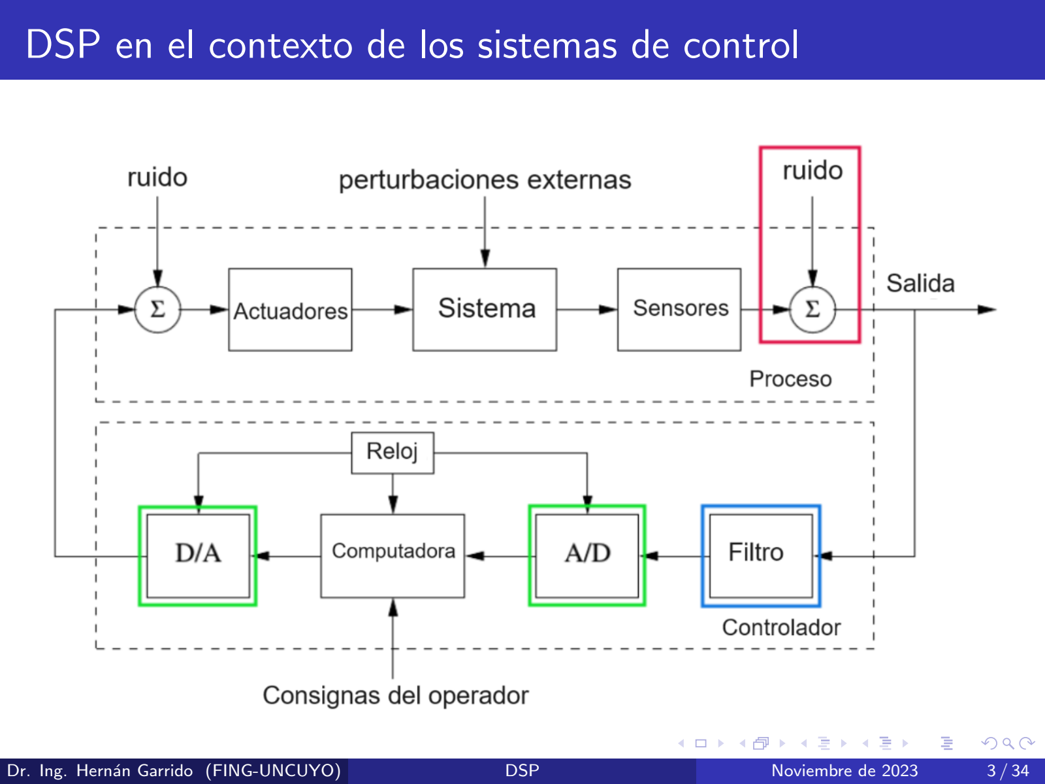
[picture p46: page 3]

Dr. Ing. Hernán Garrido (FING-UNCUYO) | DSP | Noviembre de 2023 | 3 / 34

## Etapas de un sistema de procesamiento de señales

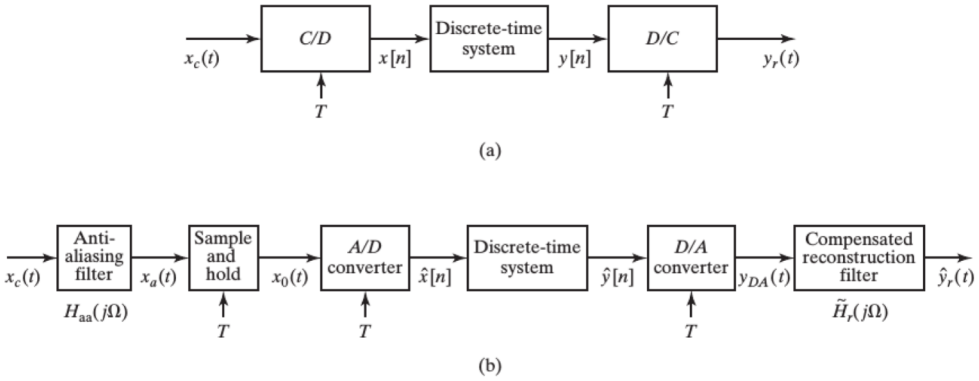
[picture p47: figure]

Dr. Ing. Hernán Garrido (FING-UNCUYO) | DSP | Noviembre de 2023 | 4 / 34

## Muestreo periódico

Si una señal en tiempo continuo xc (t) se muestrea periódicamente, se obtiene una señal en tiempo discreto:

x[n] = xc (nT)

donde T es el periodo de muestreo, n ∈ Z, fs = 1/T es la tasa de muestreo (en radianes, Ωs = 2πfs ).

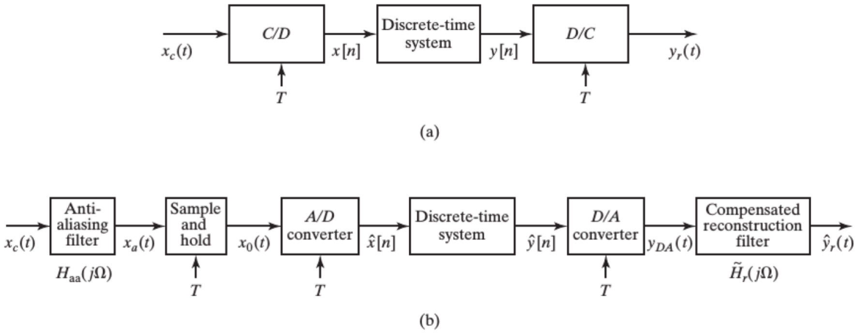
[picture p48: figure]

Dr. Ing. Hernán Garrido (FING-UNCUYO) | DSP | Noviembre de 2023 | 5 / 34

## Proceso de muestreo

El muestreo se puede interpretar como dos operaciones:
1. Multiplicación por un tren de funciones muestra unitaria (impulsos).
2. Conversión de función discontinua en t a sucesión en n.

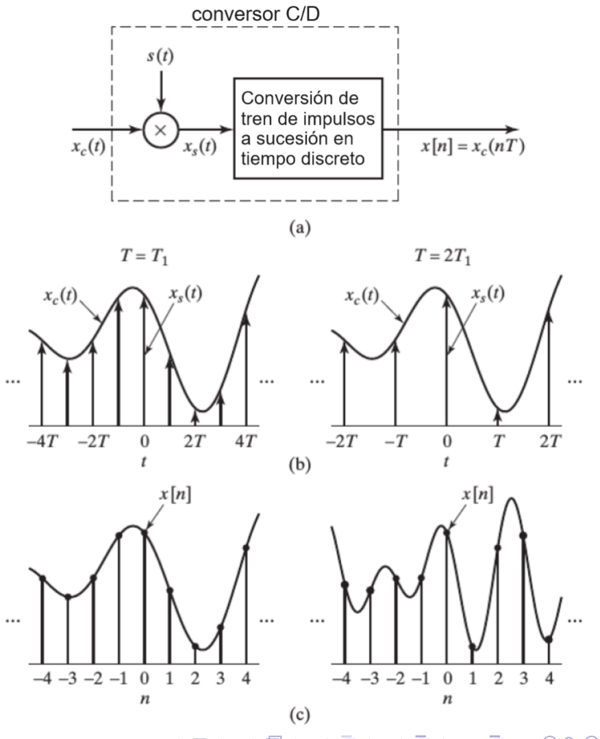
[picture p49: figure]

Dr. Ing. Hernán Garrido (FING-UNCUYO) | DSP | Noviembre de 2023 | 6 / 34

## Teorema del muestreo de Nyquist-Shannon

Teorema
Sea xc (t) una señal de banda limitada tal que:

Xc (jΩ) = 0, ∀|Ω| ≥ ΩN.

Entonces, xc (t) está determinada por sus muestras x[n] = xc (nT), n ∈ Z si

Ωs =

2π
T

≥ 2ΩN

A la frecuencia ΩN se la llama frecuencia de Nyquist, y a 2ΩN tasa de Nyquist.
La tasa de Nyquist es la mínima tasa a la que hay que muestrear la señal xc (t) para que luego pueda ser reconstruida.
Dr. Ing. Hernán Garrido (FING-UNCUYO) | DSP | Noviembre de 2023 | 7 / 34

## Teorema del muestreo en el dominio de la frecuencia

Al multiplicar la señal continua xc (t) por el tren periódico de impulsos s(t), se obtiene la señal muestreada xs (t):

xs (t) = xc (t)s(t) = xc (t)

X∞

n=−∞

δ(t − nT) = X∞

n=−∞

xc (nT)δ(t − nT)

La transformada de Fourier de la señal en tiempo continuo es:

Xc (jΩ).

La transformada de Fourier del tren de impulsos es:

S(jΩ) = 2π
T

X∞

k=−∞

δ(Ω − kΩs ), Ωs = 2π/T

La transformada de Fourier de la señal muestreada es:

Xs (jΩ) = 1
2π

Xc (jΩ) ∗ S(jΩ) = 1
T

X∞

k=−∞

Xc (j(Ω − kΩs ))

Dr. Ing. Hernán Garrido (FING-UNCUYO) | DSP | Noviembre de 2023 | 8 / 34

## Teorema del muestreo en el dominio de la frecuencia: Aliasing

Xs (jΩ) son copias
periódicamente repetidas de Xc (jΩ).

Las copias están espaciadas cada Ωs
El solapamiento comienza
cuando Ωs − ΩN = ΩN
Si Ωs ≥ 2ΩN, se evita el
solapamiento de las copias.

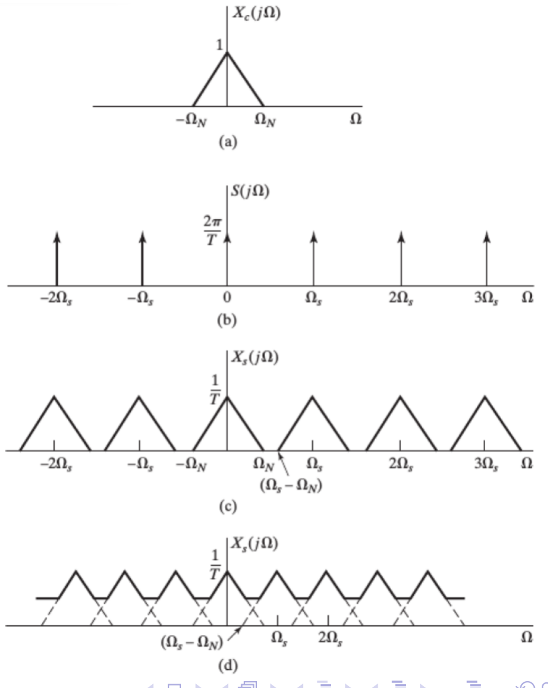
[picture p50: figure]

Dr. Ing. Hernán Garrido (FING-UNCUYO) | DSP | Noviembre de 2023 | 9 / 34

## Contenidos

1 | Introducción
2 | Filtro antialiasing
3 | Técnica de oversampling
4 | Conversión A/D
5 | Error de cuantización
6 | Relación señal-ruido de un conversor A/D y su relación con la cantidad de bits
7 | Conversión D/A
8 | Técnicas de upsampling, pre-ecualización y post-ecualización
Dr. Ing. Hernán Garrido (FING-UNCUYO) | DSP | Noviembre de 2023 | 10 / 34

## Filtro antialiasing: Necesidad

Para evitar el solapamiento o aliasing has dos caminos: Aumentar Ωs
Limitar ΩN
Incluso aumentando mucho Ωs
, puede que no se pueda evitar el aliasing si ΩN no está limitada.
Esto puede pasar incluso en señales de banda limitada por naturaleza (ejemplo, música).
Debido al ruido de banda ancha, presente en toda medición analógica.

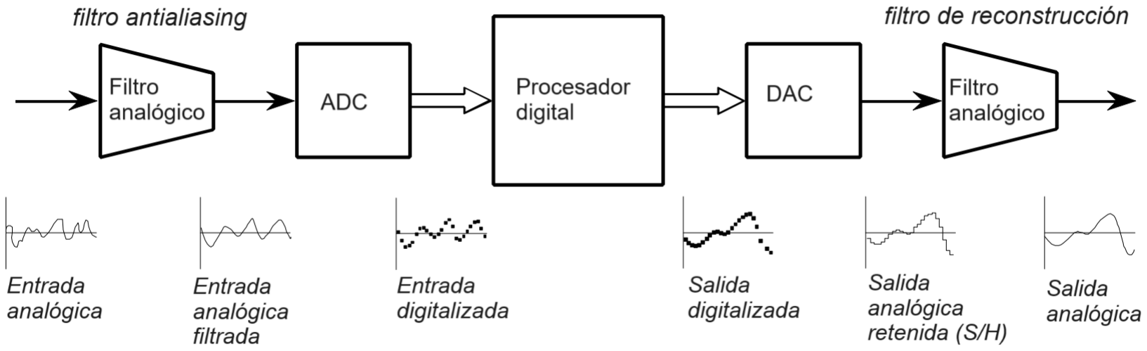
[picture p51: figure]

Dr. Ing. Hernán Garrido (FING-UNCUYO) | DSP | Noviembre de 2023 | 11 / 34

## Filtro antialiasing: Implementación

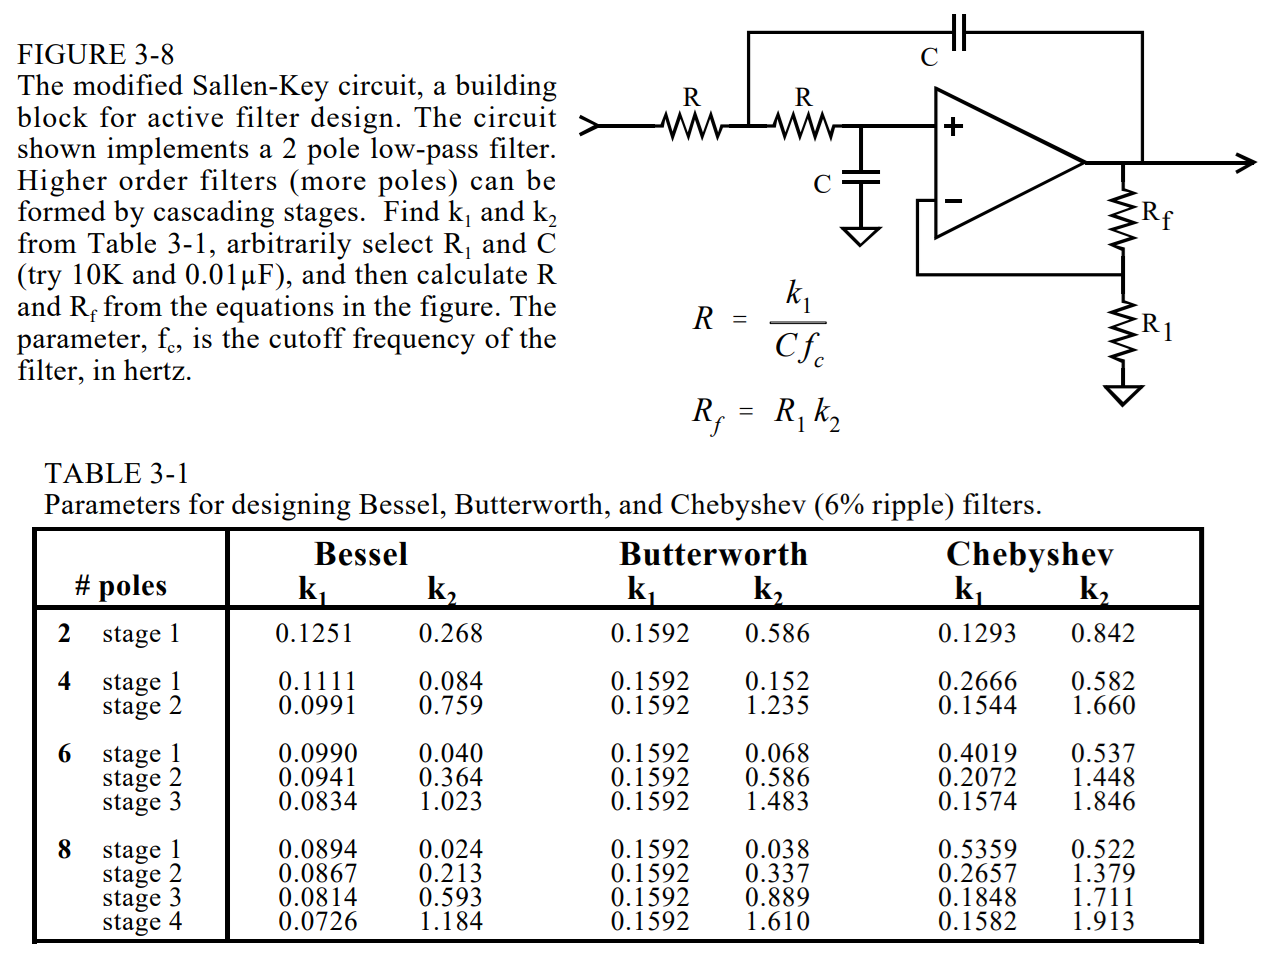
[picture p52: figure]

Figura: Tomado de Digital Signal Processing: A Practical Guide for Engineers and Scientists by Steven W. Smith; disponible en www.dspguide.com

Dr. Ing. Hernán Garrido (FING-UNCUYO) | DSP | Noviembre de 2023 | 12 / 34

## Filtro antialiasing: Limitaciones de la implementación analógica

Todo filtro tiene una banda de transición, la cual debe:
empezar luego de ΩN, para no perder señal útil, y terminar antes de Ωs − ΩN, para evitar el solapamiento.

Recordar: diapositiva 9

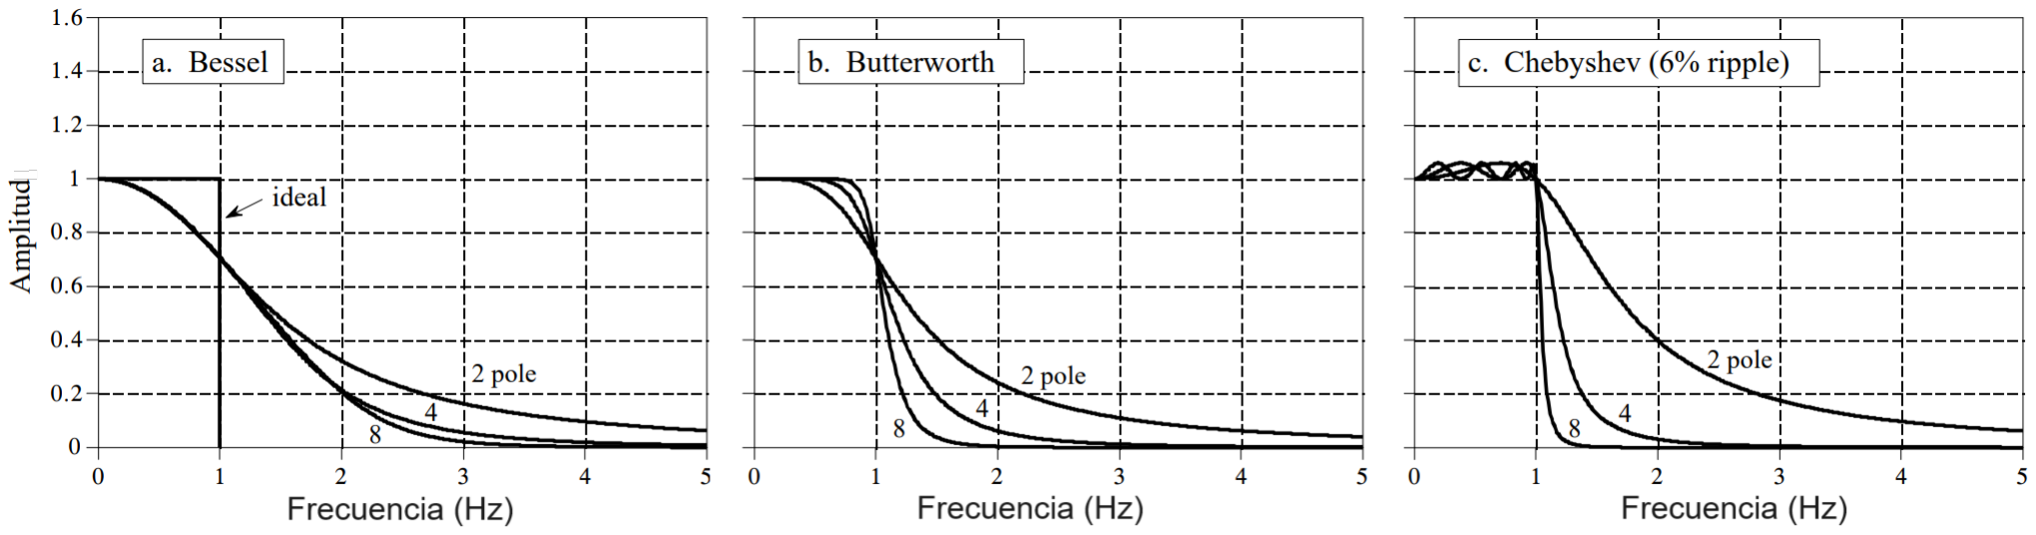
[picture p53: figure]

En los filtros analógicos es difícil hacer una banda de transición muy estrecha.

Dr. Ing. Hernán Garrido (FING-UNCUYO) | DSP | Noviembre de 2023 | 13 / 34

## Contenidos

1 | Introducción
2 | Filtro antialiasing
3 | Técnica de oversampling
4 | Conversión A/D
5 | Error de cuantización
6 | Relación señal-ruido de un conversor A/D y su relación con la cantidad de bits
7 | Conversión D/A
8 | Técnicas de upsampling, pre-ecualización y post-ecualización
Dr. Ing. Hernán Garrido (FING-UNCUYO) | DSP | Noviembre de 2023 | 14 / 34

## Técnica de oversampling: diagrama en bloques

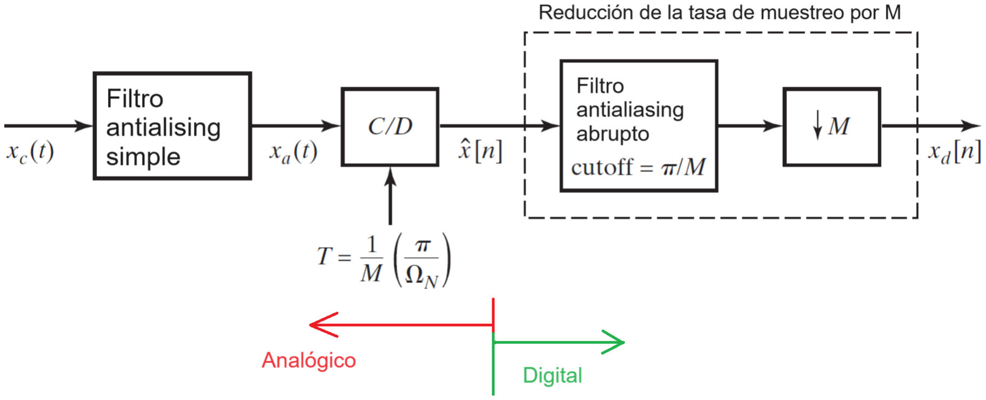
[picture p54: figure]

Dr. Ing. Hernán Garrido (FING-UNCUYO) | DSP | Noviembre de 2023 | 15 / 34

## Técnica de oversampling: análisis en la frecuencia

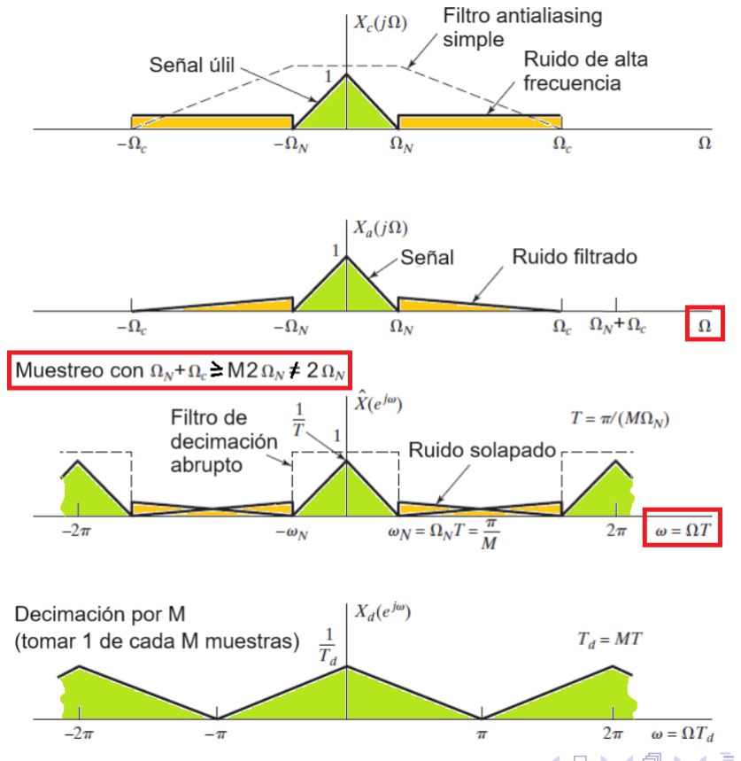
[picture p55: figure]

Dr. Ing. Hernán Garrido (FING-UNCUYO) | DSP | Noviembre de 2023 | 16 / 34

## Contenidos

1 | Introducción
2 | Filtro antialiasing
3 | Técnica de oversampling
4 | Conversión A/D
5 | Error de cuantización
6 | Relación señal-ruido de un conversor A/D y su relación con la cantidad de bits
7 | Conversión D/A
8 | Técnicas de upsampling, pre-ecualización y post-ecualización
Dr. Ing. Hernán Garrido (FING-UNCUYO) | DSP | Noviembre de 2023 | 17 / 34

## Conversión A/D

Un conversor analógico a digital (A/D) es un dispositivo físico, discreto o integrado en un microcontrolador, que:
Recibe una señal analógica de tensión constante, y
la convierte en un código binario que representa un valor cuantizado. Para trabajar con señales analógicas variables:
se agrega una etapa de muestreo y retención antes del conversor A/D; normalmente un retenedor de orden cero (zero-order-holder).

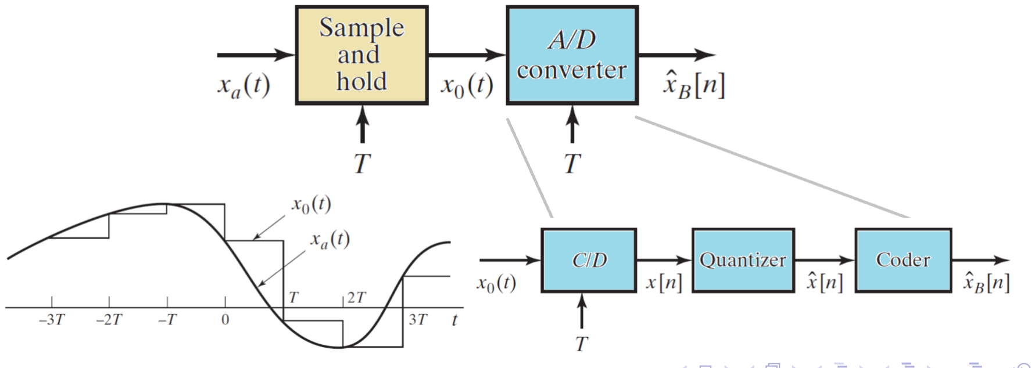
[picture p56: figure]

Dr. Ing. Hernán Garrido (FING-UNCUYO) | DSP | Noviembre de 2023 | 18 / 34

## Contenidos

1 | Introducción
2 | Filtro antialiasing
3 | Técnica de oversampling
4 | Conversión A/D
5 | Error de cuantización
6 | Relación señal-ruido de un conversor A/D y su relación con la cantidad de bits
7 | Conversión D/A
8 | Técnicas de upsampling, pre-ecualización y post-ecualización
Dr. Ing. Hernán Garrido (FING-UNCUYO) | DSP | Noviembre de 2023 | 19 / 34

## Cuantizador (quantizer)

Un cuantizador es un sistema no lineal cuyo objetivo es transformar la muestra de entrada x[n] ∈ R en uno ˆx[n] ∈ {v1, v2, ..., vn}, donde v1, v2, ..., vn son n valores prescritos.
La cantidad de valores prescritos es n = 2B+1
La precisión del cuantizador es ∆ = Vmáx−Vmín
2

B+1 =

2Xm
2

B+1 =

Xm
2

B

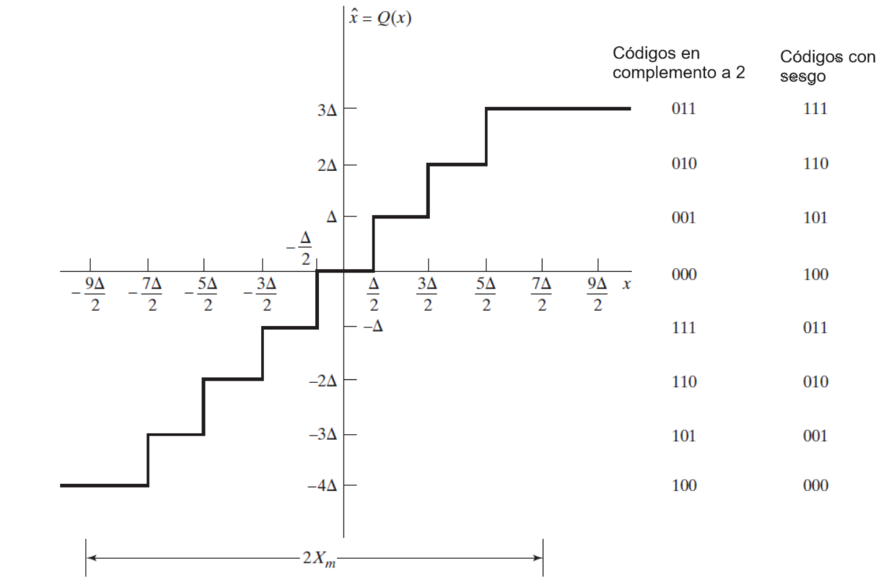
[picture p57: figure]

Dr. Ing. Hernán Garrido (FING-UNCUYO) | DSP | Noviembre de 2023 | 20 / 34

## Error de cuantización y su modelo aditivo

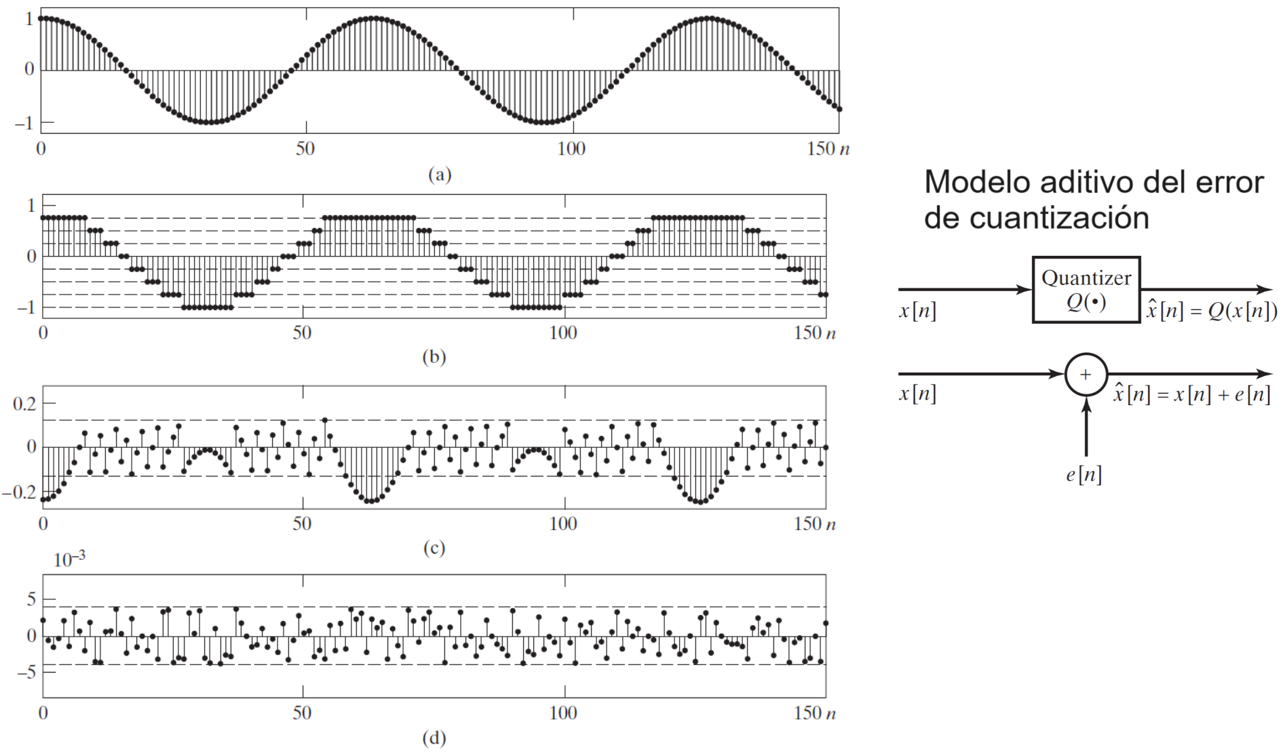
[picture p58: figure]

Figura: (b) Muestras cuantizadas de (a) con un cuantizador de 3 bits. (c) Error de cuantización con 3 bits. (d) Error de cuantización con 8 bits.

Dr. Ing. Hernán Garrido (FING-UNCUYO) | DSP | Noviembre de 2023 | 21 / 34

## Contenidos

1 | Introducción
2 | Filtro antialiasing
3 | Técnica de oversampling
4 | Conversión A/D
5 | Error de cuantización
6 | Relación señal-ruido de un conversor A/D y su relación con la cantidad de bits
7 | Conversión D/A
8 | Técnicas de upsampling, pre-ecualización y post-ecualización
Dr. Ing. Hernán Garrido (FING-UNCUYO) | DSP | Noviembre de 2023 | 22 / 34

## Relación señal-ruido de un conversor A/D y su relación con la cantidad de bits

Si ∆ es pequeño, se puede asumir que el error de cuantización está uniformemente distribuido y su función de densidad de probabilidad es:

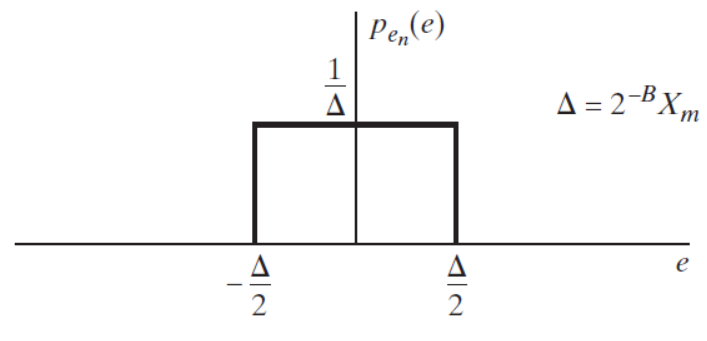
[picture p59: figure]

Por lo tanto, su varianza se puede calcular como:

σ

2
e =

Z ∆/2

−∆/2

1
∆

e

2de =

∆²

12

Si x[n] es una señal pura, la relación señal ruido de ˆx[n] resulta:

## Selección de la cantidad de bits del conversor A/D

Considere que la señal analógica muestreada, pero aún no cuantizada, es decir x[n], no es pura; si no que tiene una relación señal ruido SNRx[n] .
Si SNRADC ≥ SNRx[n]

, entonces la señal cuantizada ˆx[n] tendrá la misma relación señal ruido que la señal x[n], y los Bnoise bits menos significativos representarán ruido de la señal original, donde:

Bnoise ≈

SNRADC − SNRx[n]
6

=

20 log10
ruido en x[n]

ruido del ADC

6

Si SNRADC < SNR, entonces la señal cuantizada ˆx[n] tendrá una relación señal ruido peor que la señal original x[n].
En la práctica:
conviene elegir:

Bnoise ≥ 1.

Si Bnoise >> 1, se pueden descartar algunos antes de almacenar el dato en memoria u operar con él.

Dr. Ing. Hernán Garrido (FING-UNCUYO) | DSP | Noviembre de 2023 | 24 / 34

## Contenidos

1 | Introducción
2 | Filtro antialiasing
3 | Técnica de oversampling
4 | Conversión A/D
5 | Error de cuantización
6 | Relación señal-ruido de un conversor A/D y su relación con la cantidad de bits
7 | Conversión D/A
8 | Técnicas de upsampling, pre-ecualización y post-ecualización
Dr. Ing. Hernán Garrido (FING-UNCUYO) | DSP | Noviembre de 2023 | 25 / 34

## Conversión D/A

Un conversor digital a analógico (D/A) es un dispositivo físico, discreto o integrado en un microcontrolador, que:
Recibe un código binario que representa un valor cuantizado, y
lo convierte en una señal analógica de tensión constante.
Sus dos principales parámetros son:
Resolución: Es el número de valores distintos que puede entregar a su salida, normalmente es 2B+1 donde B + 1 es el número de bits del ADC.
Tasa de muestreo máxima: Es el máximo número de muestras por unidad de tiempo que el conversor puede entregar a su salida, de manera correcta.

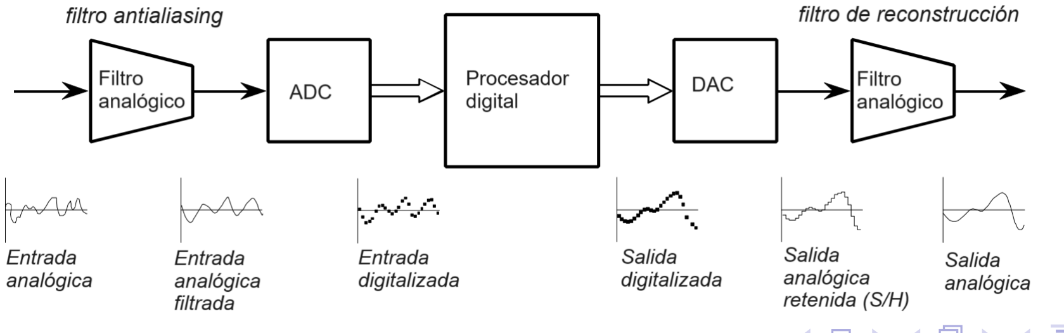
[picture p60: figure]

Dr. Ing. Hernán Garrido (FING-UNCUYO) | DSP | Noviembre de 2023 | 26 / 34

## Conversión D/A en el tiempo y en la frecuencia

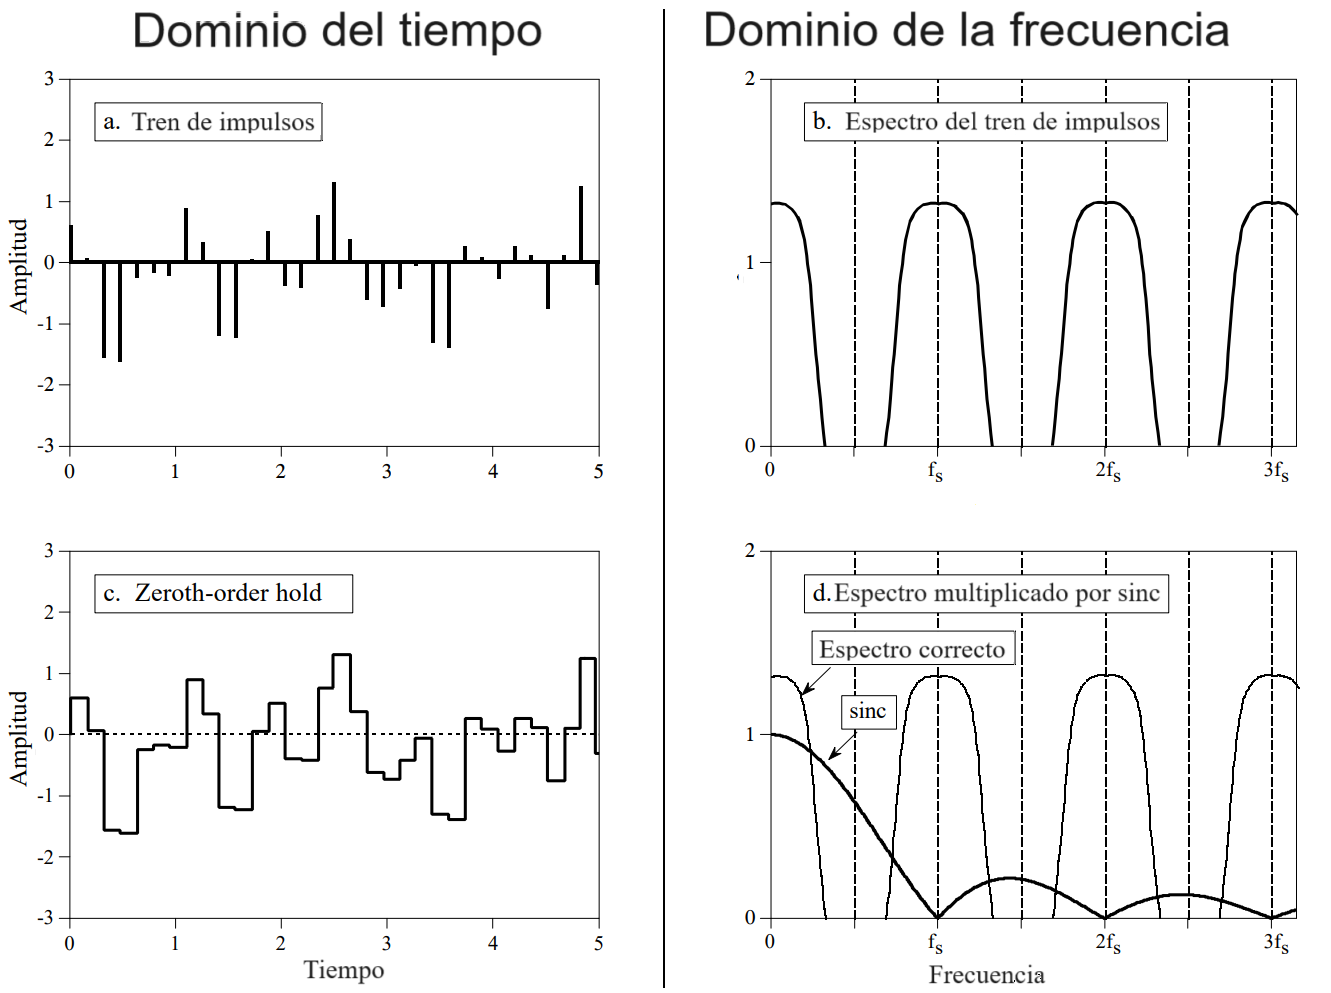
[picture p61: figure]

Dr. Ing. Hernán Garrido (FING-UNCUYO) | DSP | Noviembre de 2023 | 27 / 34

## Conversión D/A en el tiempo y en la frecuencia

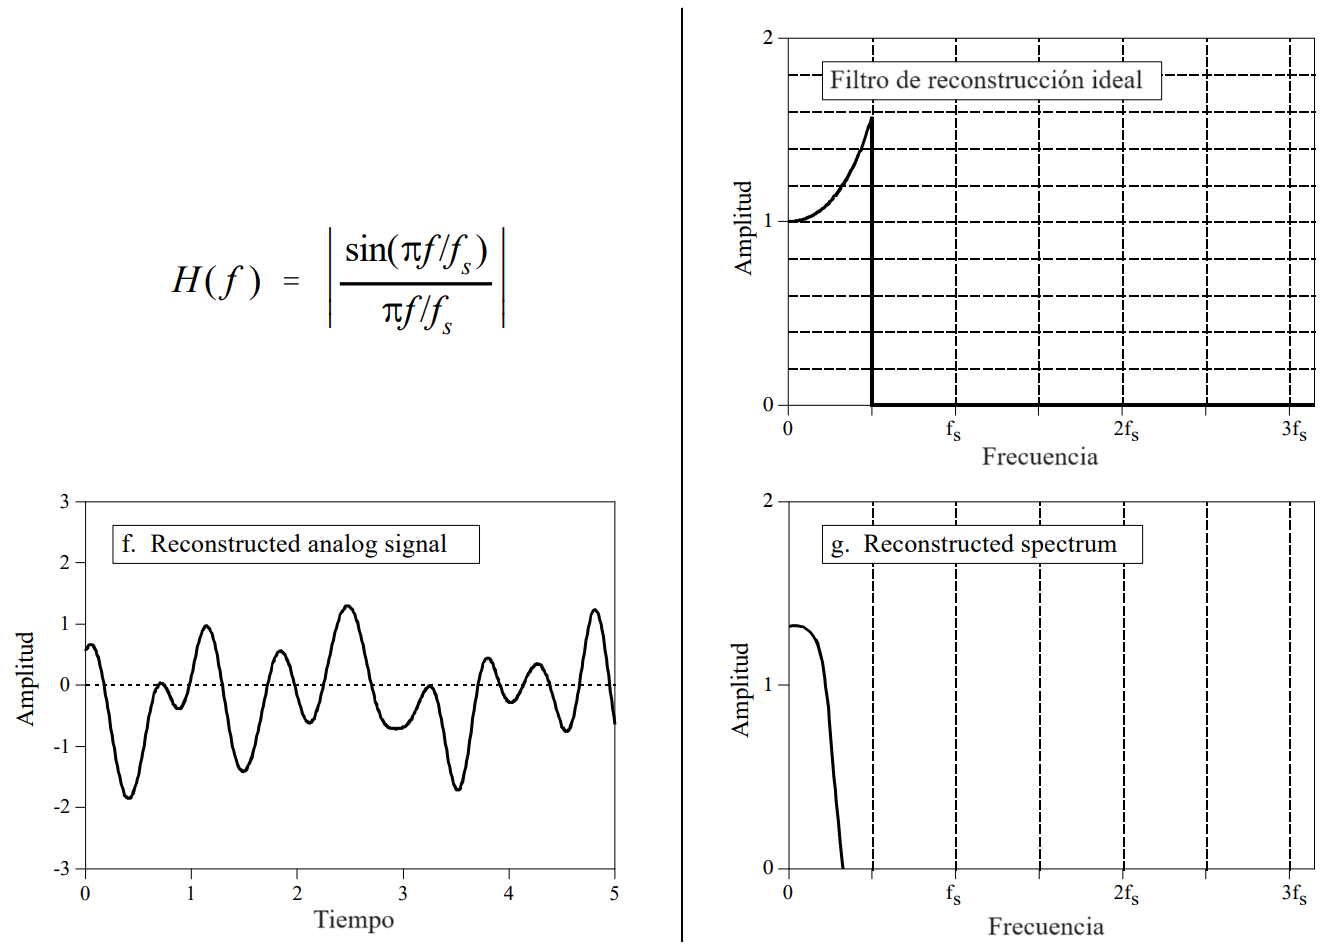
[picture p62: figure]

Dr. Ing. Hernán Garrido (FING-UNCUYO) | DSP | Noviembre de 2023 | 28 / 34

## Contenidos

1 | Introducción
2 | Filtro antialiasing
3 | Técnica de oversampling
4 | Conversión A/D
5 | Error de cuantización
6 | Relación señal-ruido de un conversor A/D y su relación con la cantidad de bits
7 | Conversión D/A
8 | Técnicas de upsampling, pre-ecualización y post-ecualización
Dr. Ing. Hernán Garrido (FING-UNCUYO) | DSP | Noviembre de 2023 | 29 / 34

## Técnicas de up-sampling, pre-ecualización y post-ecualización

Existen 4 formas de implementar la reconstrucción:

1 | No hacerla, y aceptar las consecuencias.
2 | Post-ecualización: Utilizar un filtro analógico con una respuesta en frecuencia tal que no sólo:
| elimine las altas frecuencias, si no que también refuerce las altas frecuencias dentro de la banda útil que fueron atenuadas por el ZOH.
3 | Pre-ecualización: Utilizar un filtro digital que refuerce las altas frecuencias de la banda útil antes de ingresar la señal al conversor D/A.
4 | Up-sampling: Interpolar rellenando con ceros (lo contrario de decimar), aplicar un filtro pasa-bajos digital (opcional), convertir a analógico, y finalmente el filtro analógico de reconstrucción puede ser simple.
Dr. Ing. Hernán Garrido (FING-UNCUYO) | DSP | Noviembre de 2023 | 30 / 34

## Up-sampling: Ejemplo

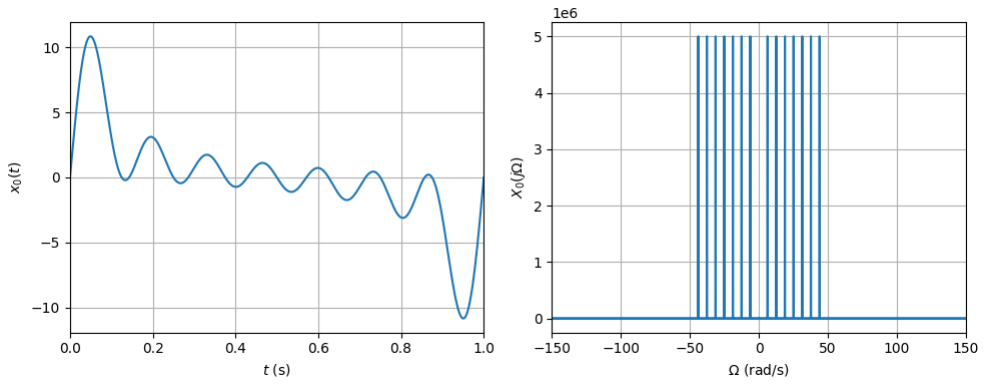
[picture p63: figure]

Dr. Ing. Hernán Garrido (FING-UNCUYO) | DSP | Noviembre de 2023 | 31 / 34

## Interpolando con ceros

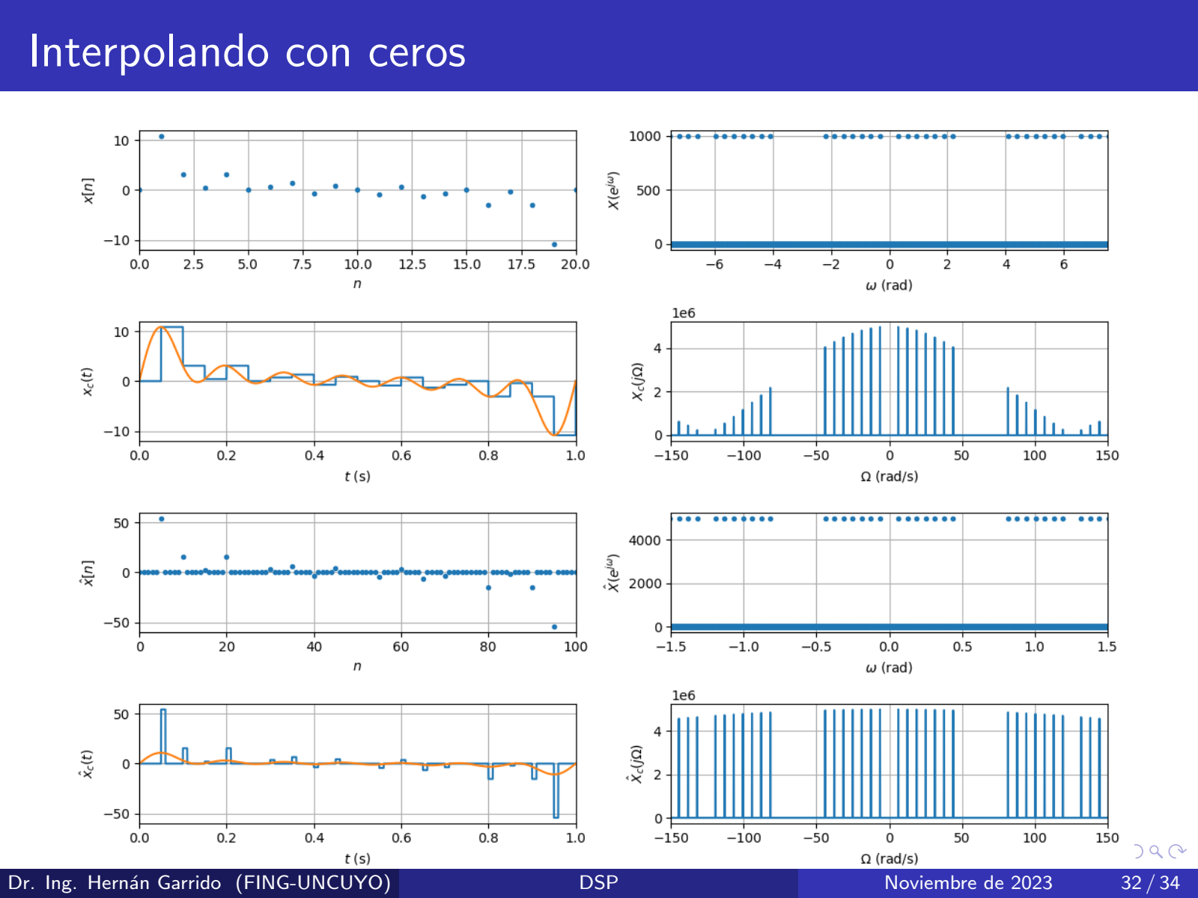
[picture p64: page 32]

Dr. Ing. Hernán Garrido (FING-UNCUYO) | DSP | Noviembre de 2023 | 32 / 34

## Interpolando con un filtro digital Butterworth de 8vo orden

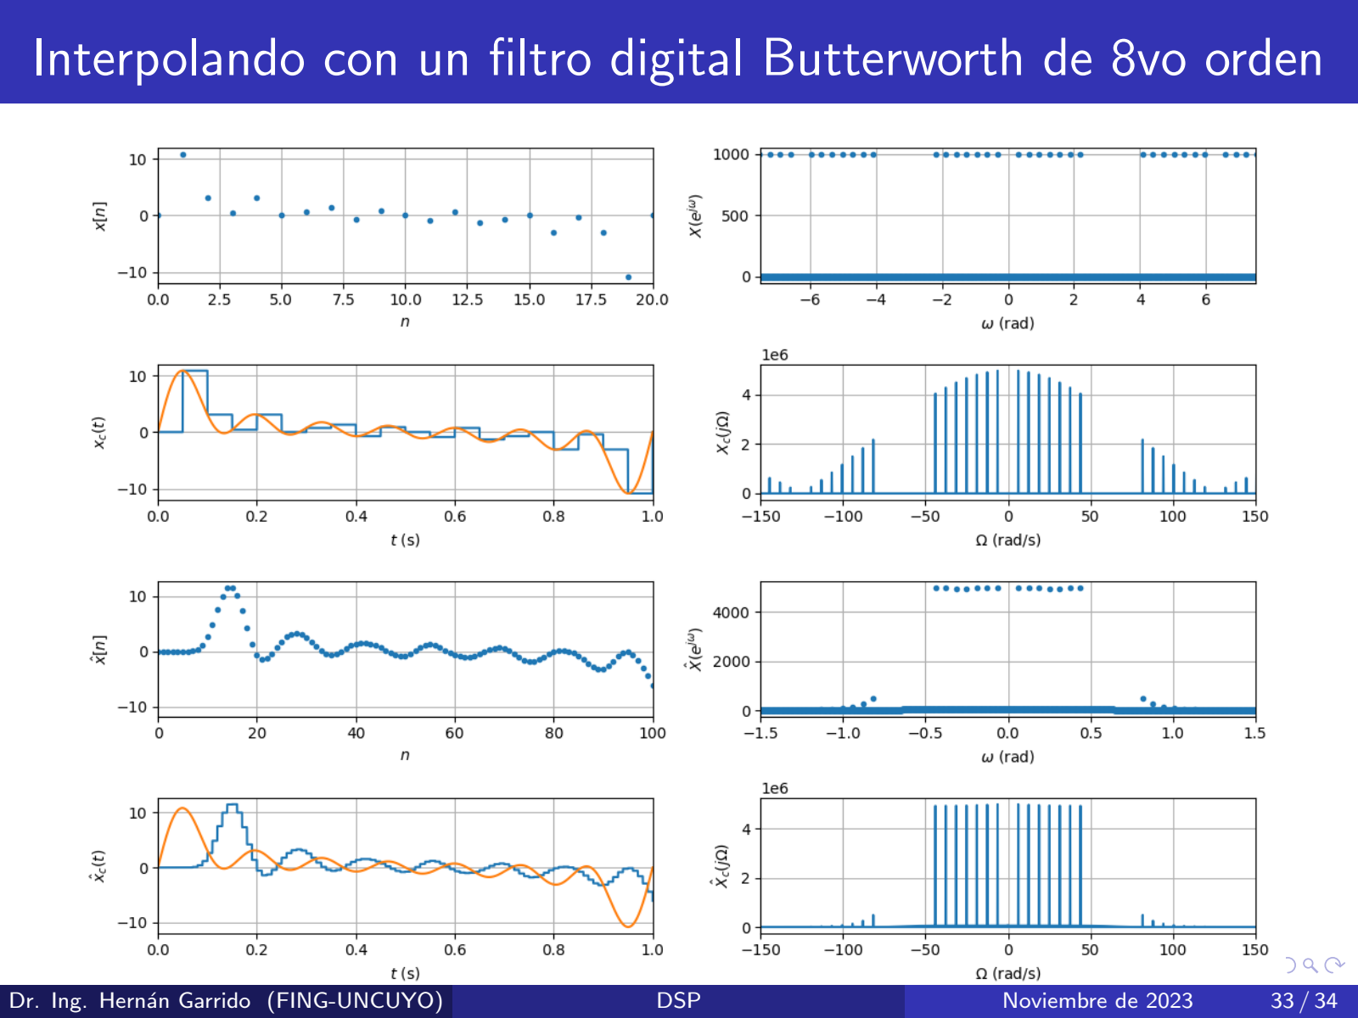
[picture p65: page 33]

Dr. Ing. Hernán Garrido (FING-UNCUYO) | DSP | Noviembre de 2023 | 33 / 34

## Bibliografía

1 | Alan V. Oppenheim and Ronald W. Schafer. Discrete-time signal processing, 3rd Ed. Prentice Hall. 2010. Section 4.3.
2 | Steven W. Smith. The Scientist and Engineer’s Guide to Digital Signal Processing. Chapter 3, ADC and DAC. Link.
3 | Maxim Integrated. Equalizing Techniques Flatten DAC Frequency Response. Application Note 3853. August 2012.
Dr. Ing. Hernán Garrido (FING-UNCUYO) | DSP | Noviembre de 2023 | 34 / 34
