fcastel2002/esc-bldc-sensorless-stm32/INFORME/ESC_Bldc___paper_congreso_utn___en_revision/imagenes_varias/diagrama_flujo_revisado.drawio.png

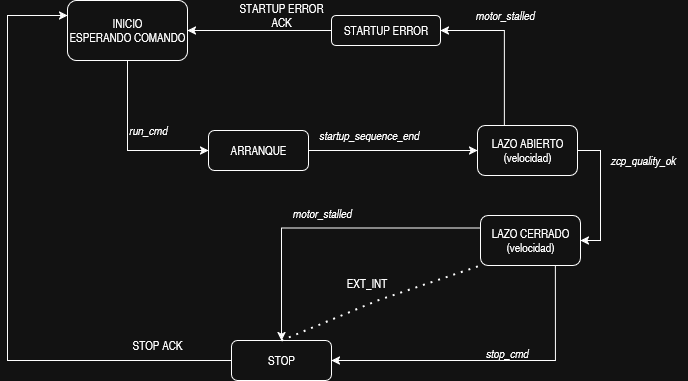
INFORME/ESC_Bldc___paper_congreso_utn___en_revision/imagenes_varias/diagrama_flujo_revisado.drawio.png
