fcastel2002/esc-bldc-sensorless-stm32/tmp/pdfs/anteproyecto/page-4.png

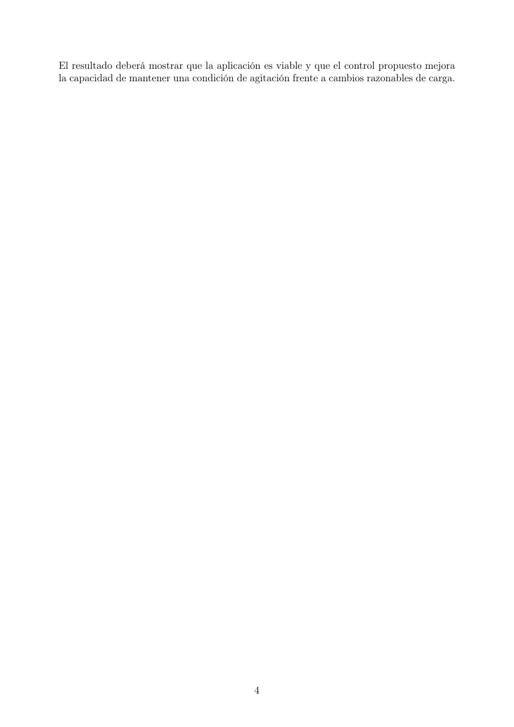
tmp/pdfs/anteproyecto/page-4.png
