fcastel2002/esc-bldc-sensorless-stm32/tmp/pdfs/current_sensing/report-05.png

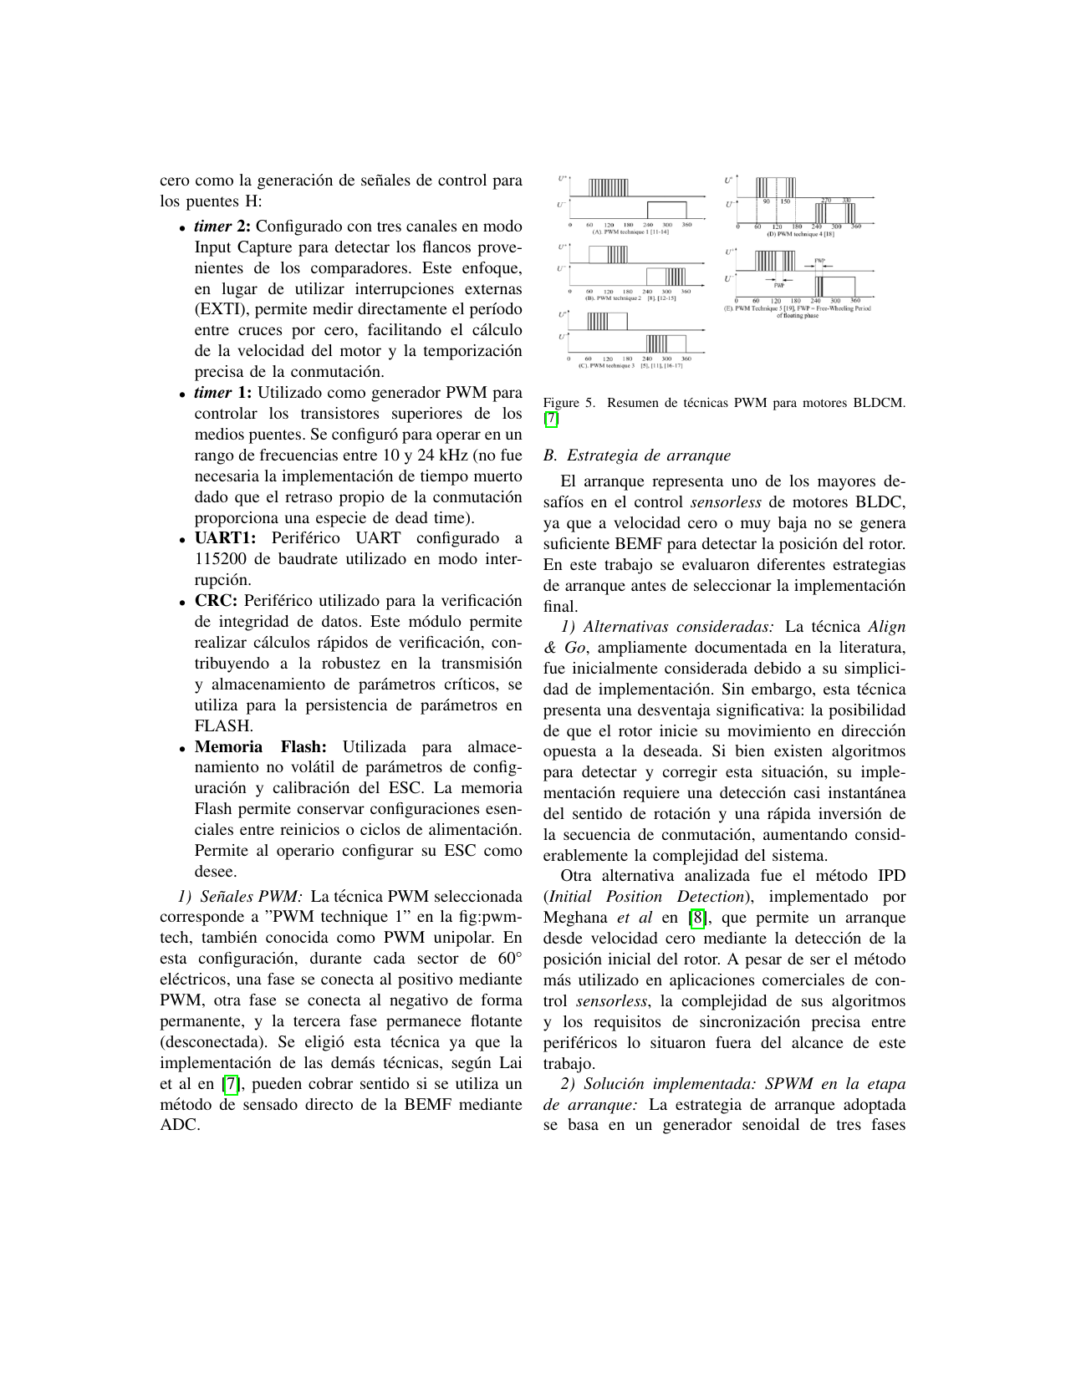
tmp/pdfs/current_sensing/report-05.png
