fcastel2002/esc-bldc-sensorless-stm32/tmp/pdfs/current_sensing/report_late-12.png

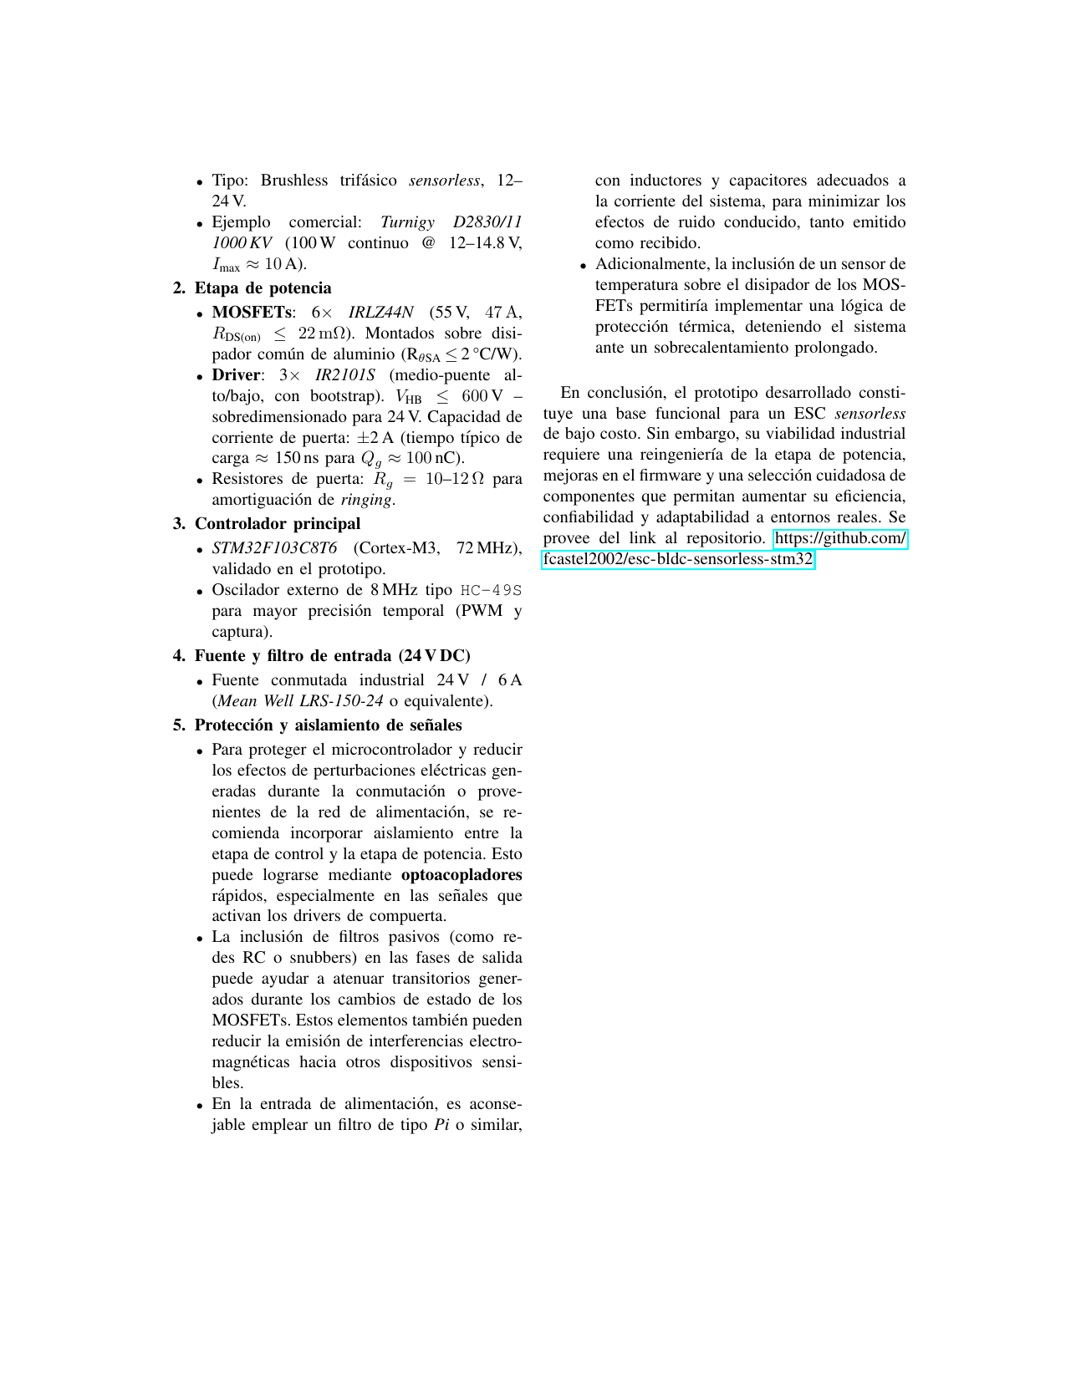
tmp/pdfs/current_sensing/report_late-12.png
