fcastel2002/esc-bldc-sensorless-stm32/tmp/pdfs/current_sensing/schematic-1.png

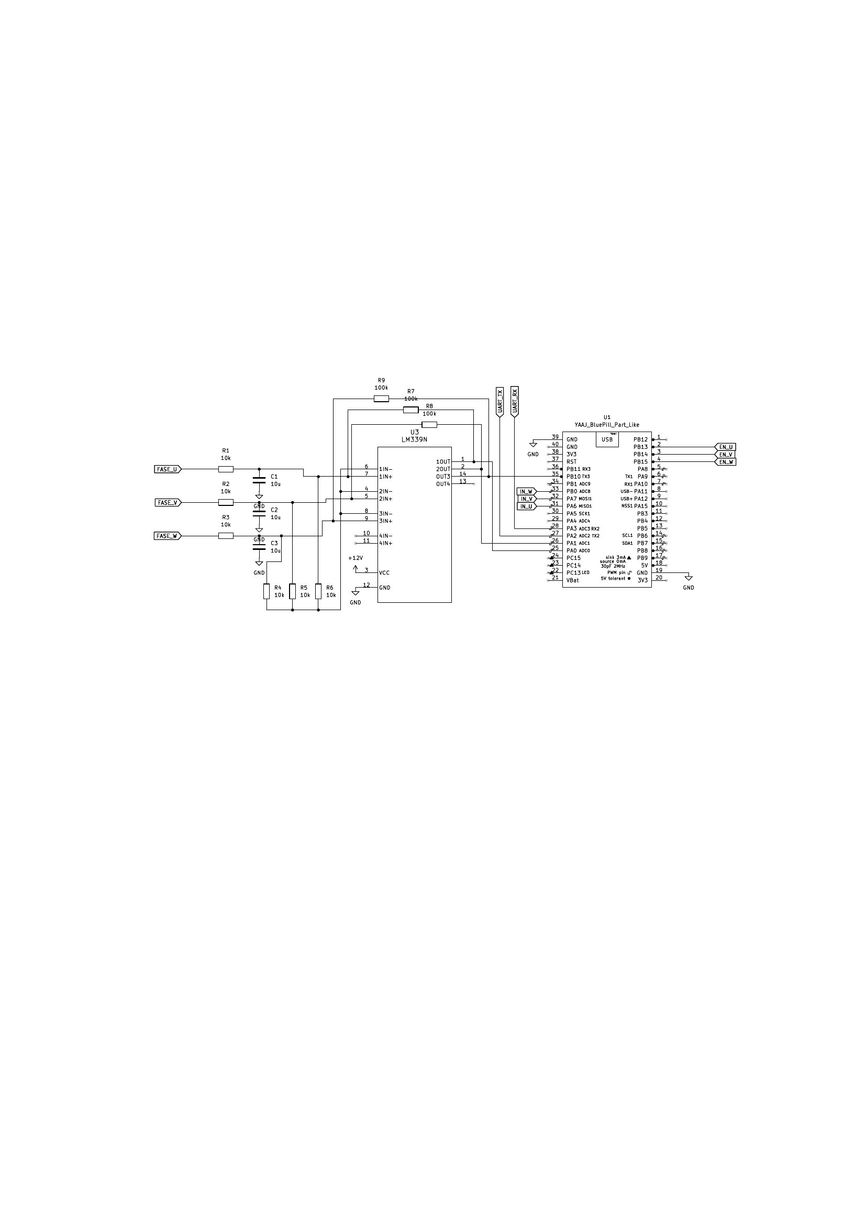
tmp/pdfs/current_sensing/schematic-1.png
