fcastel2002/esc-bldc-sensorless-stm32/simulacion_agitador/agitador.3mf

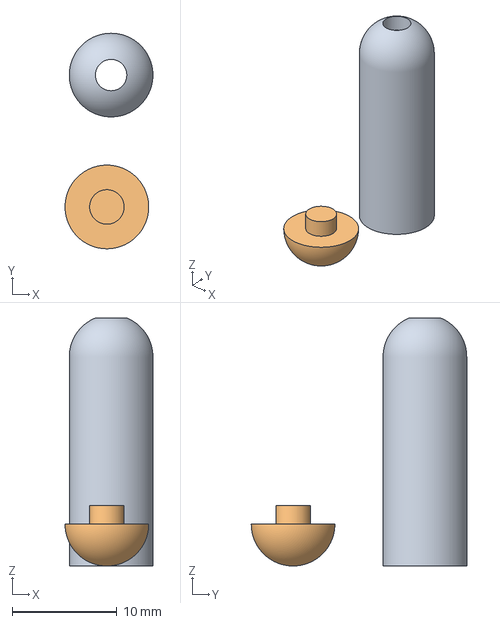
[picture p81: CAD file, 2026-08-05]
simulacion_agitador/agitador.3mf
8.40 x 20.6 x 23.7 mm
barra_agitadora_1.STEP
barra_agitador_cap.STEP
