fcastel2002/esc-bldc-sensorless-stm32/simulacion_agitador/cad/barra_agitador_cap.STEP

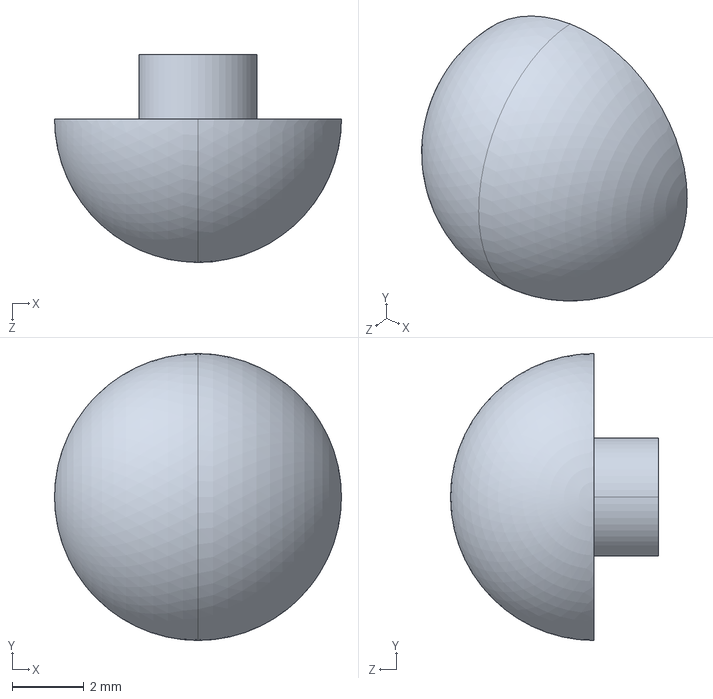
[picture p82: CAD file, 2026-08-05]
simulacion_agitador/cad/barra_agitador_cap.STEP
8.00 x 8.00 x 5.80 mm
