fcastel2002/esc-bldc-sensorless-stm32/simulacion_agitador/cad/soporte_motor.STEP

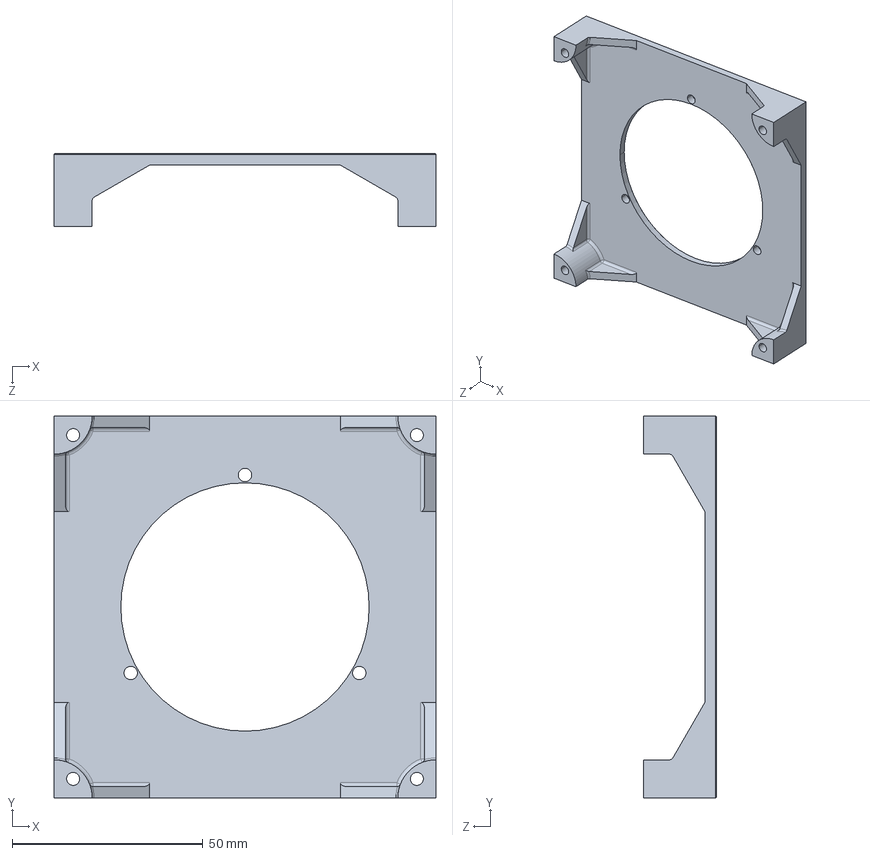
[picture p83: CAD file, 2026-08-05]
simulacion_agitador/cad/soporte_motor.STEP
100.0 x 100.0 x 19.0 mm
