fcastel2002/esc-bldc-sensorless-stm32/simulacion_agitador/cad/base_plana.STEP

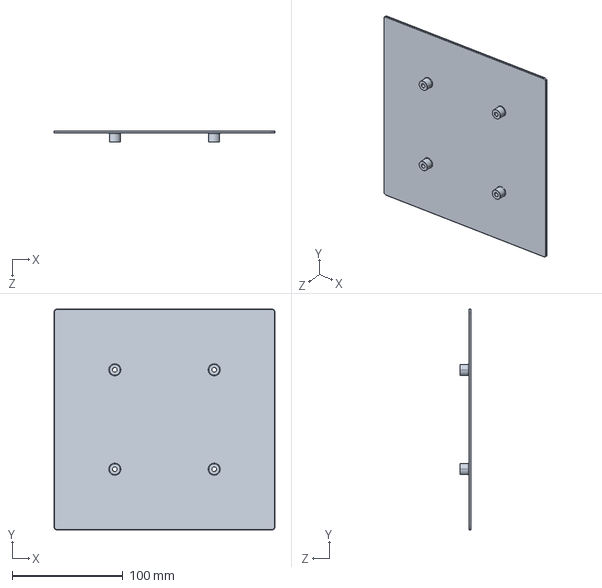
[picture p84: CAD file, 2026-08-05]
simulacion_agitador/cad/base_plana.STEP
200.0 x 200.0 x 10.0 mm
