fcastel2002/esc-bldc-sensorless-stm32/simulacion_agitador/cad/bracket_plastico.STEP

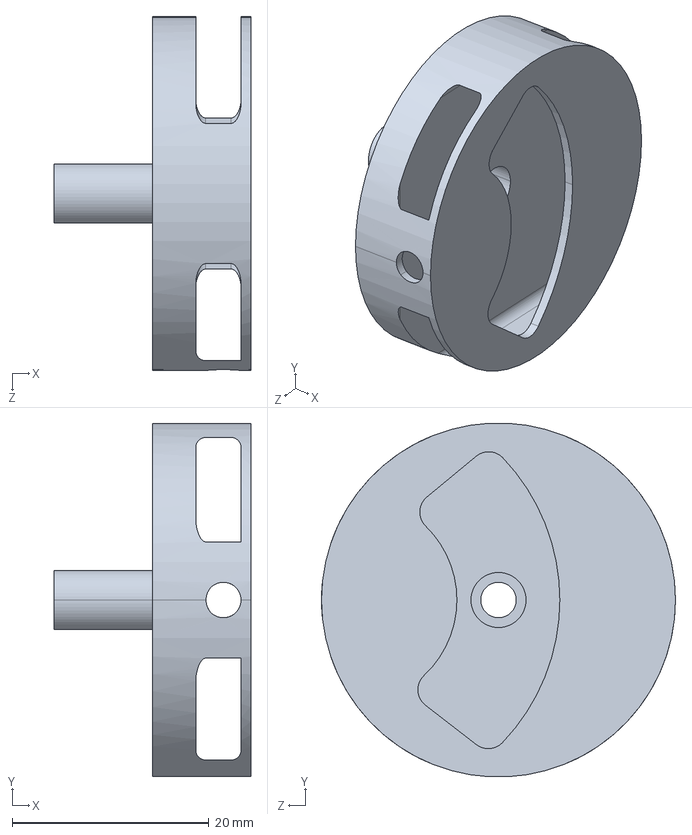
[picture p85: CAD file, 2026-08-05]
simulacion_agitador/cad/bracket_plastico.STEP
20.0 x 35.9 x 36.0 mm
