fcastel2002/esc-bldc-sensorless-stm32/simulacion_agitador/cad/base_agitador.STEP

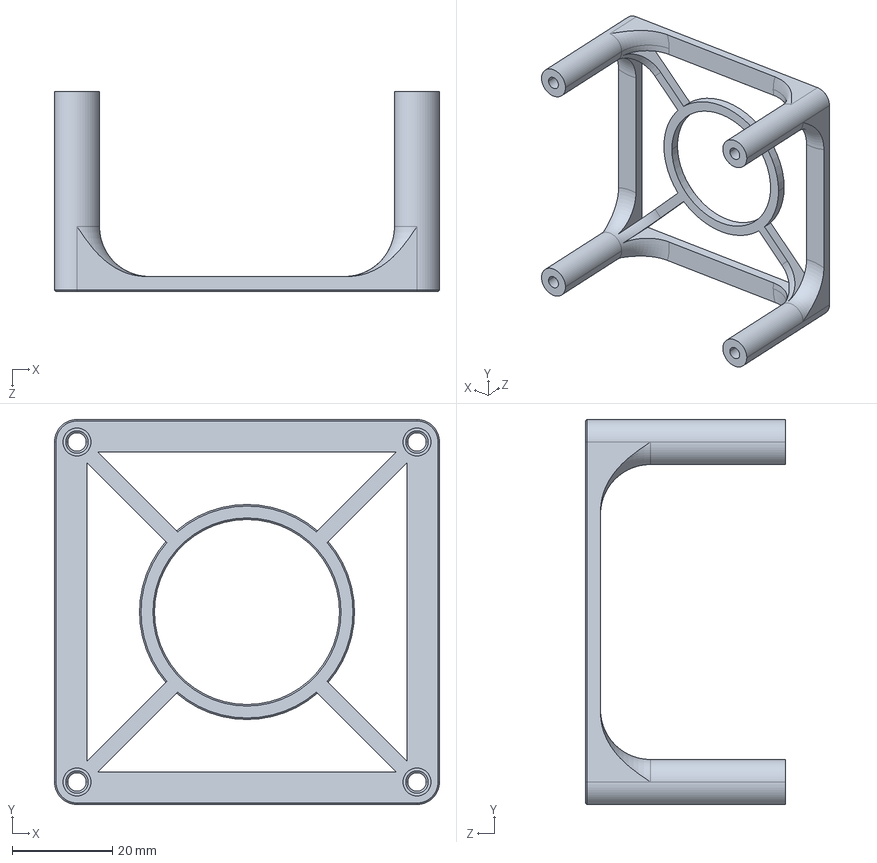
[picture p86: CAD file, 2026-08-05]
simulacion_agitador/cad/base_agitador.STEP
77.0 x 77.0 x 40.0 mm
