fcastel2002/esc-bldc-sensorless-stm32/simulacion_agitador/cad/barra_agitadora.SLDASM

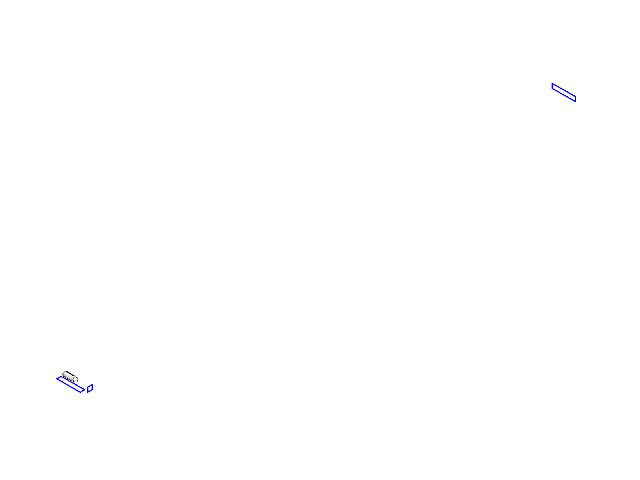
[picture p87: CAD file, 2026-08-05]
simulacion_agitador/cad/barra_agitadora.SLDASM
barra_agitadora_1
barra_agitador_cap
