fcastel2002/esc-bldc-sensorless-stm32/(list of files, cad)

Other CAD files:
simulacion_agitador/cad/barra_agitador_cap.SLDPRT
simulacion_agitador/cad/barra_agitadora_1.SLDPRT
simulacion_agitador/cad/base_agitador.SLDPRT
simulacion_agitador/cad/base_plana.SLDPRT
simulacion_agitador/cad/bracket_plastico.SLDPRT
simulacion_agitador/cad/soporte_motor.SLDPRT
