fcastel2002/esc-bldc-sensorless-stm32/specs/000-repo-ssd-setup/tasks.md

# 000 Repo SSD Setup Tasks

## Tasks

- [x] T001 Keep root `AGENTS.md` as canonical guidance without a `CLAUDE.md` mirror.
- [x] T002 Add firmware-specific `firmware/AGENTS.md`.
- [x] T003 Add GUI-specific `gui/EscGui/AGENTS.md`.
- [x] T004 Add documentation indexes and architecture docs.
- [x] T005 Add SSD workflow docs and templates.
- [x] T006 Add initial `000-repo-ssd-setup` spec package.
- [x] T007 Add GitHub Actions CI, release, docs workflows, and Dependabot.
- [x] T008 Update root README with SSD and CI/CD links.
- [x] T009 Run local firmware Debug configure/build.
- [x] T010 Run local GUI build and tests.
- [x] T011 Record verification results.
- [x] T012 Record agent guidance location decision and retire tracked `.codex/` files.

## Notes

Do not clean tracked generated artifacts as part of this feature.
