fcastel2002/esc-bldc-sensorless-stm32/specs/templates/test-plan.md

# NNN Feature Test Plan

## Local Checks

- [ ] Command or manual check.

## CI Checks

- [ ] Expected workflow/job.

## Hardware / HIL Checks

- [ ] Manual or lab validation, if required.

## Regression Areas

- Area 1.

## Results

Record exact commands, dates, and outcomes before moving the spec to `Verified`.
