fcastel2002/esc-bldc-sensorless-stm32/specs/templates/changelog.md

# NNN Feature Changelog

## Unreleased

- Added:
- Changed:
- Fixed:
- Docs:
- Tests:

## Notes

Keep entries user-visible and traceable to task IDs when possible.
