fcastel2002/esc-bldc-sensorless-stm32/specs/000-repo-ssd-setup/changelog.md

# 000 Repo SSD Setup Changelog

## Unreleased

- Added: SSD folder structure, templates, and initial setup spec.
- Added: documentation indexes for build/test, CI/CD, repo map, and protocol ownership.
- Added: subproject `AGENTS.md` files and kept root `AGENTS.md` as canonical guidance.
- Added: `.agents/README.md` and decision record for agent guidance location.
- Changed: removed tracked `.codex/` files and root `CLAUDE.md` mirror.
- Added: GitHub Actions CI/CD workflows and Dependabot configuration.
- Added: root README links to docs, SSD, CI/CD, and protocol ownership.
- Tests: local repo hygiene, SSD docs validation, firmware Debug build, GUI build, and GUI tests passed.
