fcastel2002/esc-bldc-sensorless-stm32/INFORME/esquematico_zc.pdf

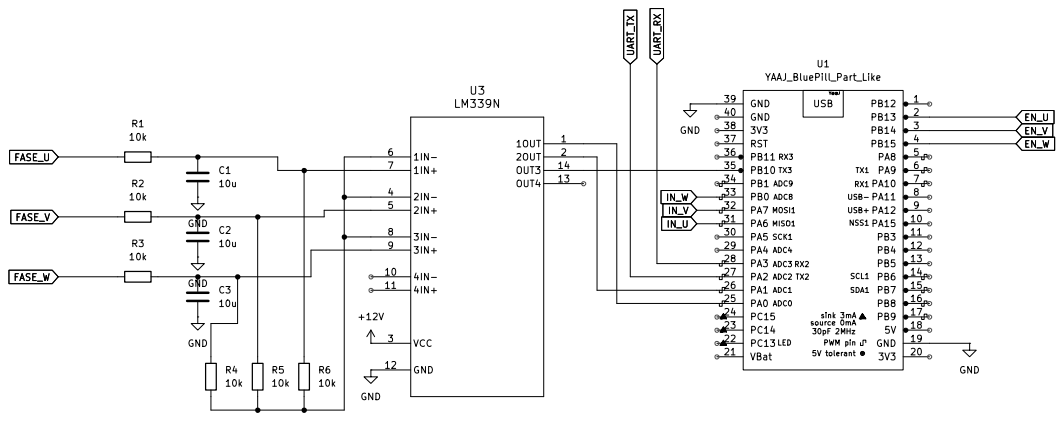
[picture p89: page 1]
