fcastel2002/esc-bldc-sensorless-stm32/INFORME/ESC_Bldc___paper_congreso_utn___en_revision/imagenes_circuitos/esquematico_2zc.pdf

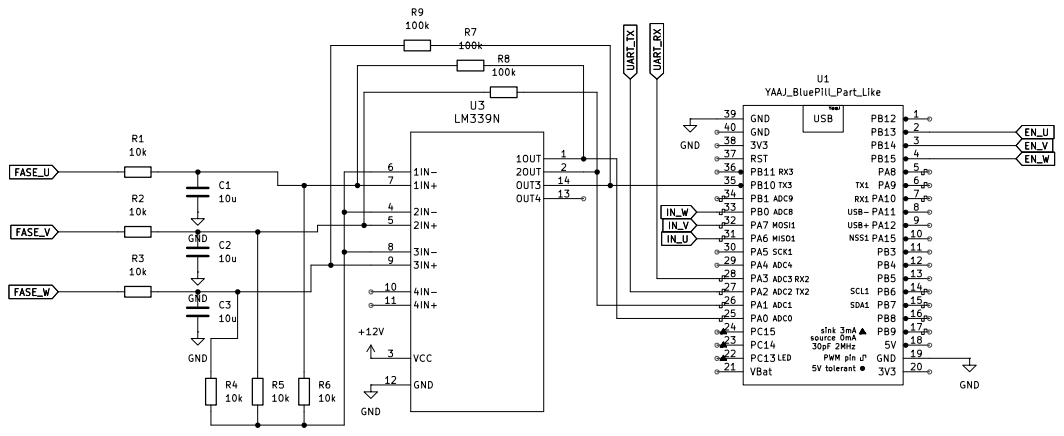
[picture p90: page 1]
