fcastel2002/esc-bldc-sensorless-stm32/firmware/Core/Src/main.c

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
/* Includes ------------------------------------------------------------------*/
#include "main.h"
#include "adc.h"
#include "crc.h"
#include "tim.h"
#include "usart.h"
#include "gpio.h"

/* USER CODE BEGIN Includes */
#include "current_sense.h"
/* USER CODE END Includes */


/* USER CODE BEGIN PV */

extern const uint32_t CPU_clock = 72000000;
/* USER CODE END PV */

void SystemClock_Config(void);
/* USER CODE BEGIN 0 */

volatile uint32_t led_tick = 0;
/* USER CODE END 0 */

/**
  * @brief  The application entry point.
  * @retval int
  */
int main(void)
{

  /* MCU Configuration--------------------------------------------------------*/

  /* Reset of all peripherals, Initializes the Flash interface and the Systick. */
  HAL_Init();

  /* Configure the system clock */
  SystemClock_Config();

  /* Initialize all configured peripherals */
  MX_GPIO_Init();
  MX_TIM4_Init();
  MX_TIM2_Init();
  MX_TIM1_Init();
  MX_CRC_Init();
  MX_TIM3_Init();
  MX_USART1_UART_Init();
  MX_ADC2_Init();
  MX_ADC1_Init();
  /* USER CODE BEGIN 2 */
  current_sense_init();
  HAL_GPIO_WritePin(LED_GPIO_Port, LED_Pin, GPIO_PIN_RESET);
  TIM1->PSC = 0;
  HAL_TIM_IC_Start_IT(&htim2, TIM_CHANNEL_1);
  HAL_TIM_IC_Start_IT(&htim2, TIM_CHANNEL_2);
  HAL_TIM_IC_Start_IT(&htim2, TIM_CHANNEL_3);

  detect_motor();
  volatile uint32_t last_led_tick = 0;
  /* USER CODE END 2 */

  /* Infinite loop */
  /* USER CODE BEGIN WHILE */
  while (1) {
    handleState();
    check_motor_status();
    if ((uint32_t)(led_tick - last_led_tick) >= 200) {
      HAL_GPIO_TogglePin(LED_GPIO_Port, LED_Pin);
      last_led_tick = led_tick;
    }
    /* USER CODE END WHILE */

    /* USER CODE BEGIN 3 */
  }
  /* USER CODE END 3 */
}

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
