fcastel2002/esc-bldc-sensorless-stm32/firmware/Core/Inc/main.h

#define LED_Pin GPIO_PIN_13
#define LED_GPIO_Port GPIOC
#define W_Pin GPIO_PIN_0
#define W_GPIO_Port GPIOA
#define U_Pin GPIO_PIN_1
#define U_GPIO_Port GPIOA
#define EN_W_Pin GPIO_PIN_5
#define EN_W_GPIO_Port GPIOA
#define EN_U_PWM_Pin GPIO_PIN_6
#define EN_U_PWM_GPIO_Port GPIOA
#define EN_V_PWM_Pin GPIO_PIN_7
#define EN_V_PWM_GPIO_Port GPIOA
#define EN_W_PWM_Pin GPIO_PIN_0
#define EN_W_PWM_GPIO_Port GPIOB
#define EN_V_Pin GPIO_PIN_1
#define EN_V_GPIO_Port GPIOB
#define V_Pin GPIO_PIN_10
#define V_GPIO_Port GPIOB
#define EN_U_Pin GPIO_PIN_13
#define EN_U_GPIO_Port GPIOB
#define IN_U_Pin GPIO_PIN_8
#define IN_U_GPIO_Port GPIOA
#define IN_V_Pin GPIO_PIN_9
#define IN_V_GPIO_Port GPIOA
#define IN_W_Pin GPIO_PIN_10
#define IN_W_GPIO_Port GPIOA
#define COMM_MODE_Pin GPIO_PIN_8
#define COMM_MODE_GPIO_Port GPIOB
