fcastel2002/esc-bldc-sensorless-stm32/firmware/Core/Inc/speed_sensor.h

#ifndef INC_SPEED_SENSOR_H_
#define INC_SPEED_SENSOR_H_


#define ZCP_VALID_MAX_THRESHOLD 50000
#define ZCP_VALID_MIN_THRESHOLD 50
#define SPEED_MAX 200 // pwm
#define SPEED_MIN 14000
#define SPEED_RANGE (SPEED_MIN - SPEED_MAX)
#define ZCP_TO_CHECK 4

//sensado de velocidad
#define SPEED_TOLERANCE_PCT 25
#define ZCP_BUFFER_SIZE 2
#define PHASE_COUNT 3
#define SPEED_CONSENSUS_THRESHOLD 15 // % de tolerancia entre fases
#include <stdint.h>
#include <stdbool.h>
#include "utilities.h"
// Estructura para cada fase
typedef struct {
  uint16_t last_timestamp;
  uint16_t periods[ZCP_BUFFER_SIZE];
  uint8_t  period_idx;
  uint8_t  valid_periods;
  uint16_t avg_period;
  uint8_t  is_consistent;
} PhaseMeasurementThreePhase;


extern uint16_t period_to_rpm(uint16_t period);
extern uint16_t rpm_to_period(uint16_t rpm);
extern uint16_t get_actual_speed(void);

// api externa
extern void speed_sensor_init(void);
extern void speed_sensor_zc_detected(uint8_t phase, uint16_t timestamp);
extern uint16_t speed_sensor_get_speed_rpm(void);
extern uint16_t speed_sensor_get_speed_period(void);
extern uint8_t speed_sensor_get_bemf_quality_flags(void);
extern bool speed_sensor_is_ready(void);
extern void speed_sensor_reset(void);
extern void speed_sensor_handle_W_measurement(uint16_t current_timestamp);
extern void speed_sensor_handle_consensus(void);
extern uint16_t speed_sensor_get_speed_range(void);
extern void speed_sensor_process_phase_measurement(uint8_t phase_idx, uint16_t current_timestamp);
#endif /* INC_SPEED_SENSOR_H_ */
