fcastel2002/esc-bldc-sensorless-stm32/firmware/Core/Src/isr_callbacks.c

/*
 * callbacks.c
 *
 *  Created on: Feb 5, 2025
 *      Author: Usuario
 */

#include "tim.h"
#include "motor_control.h"
#include "current_sense.h"

#pragma GCC optimize("Os")


void HAL_TIM_IC_CaptureCallback(TIM_HandleTypeDef* htim)
{
  if (htim->Instance == TIM2) {
    __disable_irq();
    uint8_t channel = 0;
    if (htim->Channel == HAL_TIM_ACTIVE_CHANNEL_1 && floating_W) {
      channel = 1;
      zero_crossing_handler(channel, HAL_TIM_ReadCapturedValue(htim, TIM_CHANNEL_1));
    } else if (htim->Channel == HAL_TIM_ACTIVE_CHANNEL_2 && floating_U) {
      channel = 2;
      zero_crossing_handler(channel, HAL_TIM_ReadCapturedValue(htim, TIM_CHANNEL_2));
    } else if (htim->Channel == HAL_TIM_ACTIVE_CHANNEL_3 && floating_V) {
      channel = 3;
      zero_crossing_handler(channel, HAL_TIM_ReadCapturedValue(htim, TIM_CHANNEL_3));
    }
    __enable_irq();
  }
  if (htim->Instance == TIM1) {
    // pwm_input(htim);
  }
}

void HAL_TIM_OC_DelayElapsedCallback(TIM_HandleTypeDef* htim)
{
  if (htim->Instance == TIM4 && htim->Channel == HAL_TIM_ACTIVE_CHANNEL_3) {
    // TIM3->CCER &= ~(TIM_CCER_CC1E | TIM_CCER_CC2E | TIM_CCER_CC3E | TIM_CCER_CC4E);
    // event_delay();
  }
  if (htim->Instance == TIM4 && htim->Channel == HAL_TIM_ACTIVE_CHANNEL_1 &&
      CLOSEDLOOP == app_state &&
      hil_session_state != (uint8_t)HIL_EXECUTION_STEPPED + 1U) {
    pi_control();
  }
}
void HAL_TIM_PeriodElapsedCallback(TIM_HandleTypeDef* htim)
{
  if (htim->Instance == TIM4) {
    if (hil_session_state != (uint8_t)HIL_EXECUTION_STEPPED + 1U) {
      update_pwm_startup_foc();
    }
  }
}

void HAL_ADCEx_InjectedConvCpltCallback(ADC_HandleTypeDef* hadc)
{
  if (hadc->Instance == ADC1) {
    current_sense_handle_conversion();
  }
}
