fcastel2002/esc-bldc-sensorless-stm32/firmware/Core/Inc/flash_config.h

/*
 * flash_config.h
 *
 *  Created on: Mar 19, 2025
 *      Author: Pachi
 */

#ifndef INC_FLASH_CONFIG_H_
#define INC_FLASH_CONFIG_H_

#include "main.h"

#define FLASH_CONFIG_PAGES 2 // nro de paginas rotativas
#define FLASH_CONFIG_START (FLASH_BASE + 64 * 1024 - (FLASH_PAGE_SIZE * FLASH_CONFIG_PAGES))
#define FLASH_CONFIG_SIGNATURE 0xABCD1234

typedef enum {
  FLASH_RESULT_OK,
  FLASH_RESULT_EMPTY,
  FLASH_RESULT_CORRUPT,
  FLASH_RESULT_WRITE_ERROR,
  FLASH_RESULT_ERASE_ERROR
} FlashResultCode;

void flash_config_parameter_changed();

FlashResultCode flash_config_init(void);

FlashResultCode flash_config_save(void);

FlashResultCode flash_config_restore_defaults(void);

uint8_t flash_config_get_stats(uint32_t* write_count);

uint8_t flash_config_has_pending_changes(void);

#endif /* INC_FLASH_CONFIG_H_ */
