fcastel2002/esc-bldc-sensorless-stm32/firmware/Core/Inc/utilities.h

#ifndef INC_UTILITIES_H_
#define INC_UTILITIES_H_

#include <stdint.h>
#include <stdbool.h>
#include <math.h>
#include "stm32f1xx_hal.h"
extern int8_t safe_mod(int8_t value, int8_t mod);


#endif /* INC_UTILITIES_H_ */
