fcastel2002/esc-bldc-sensorless-stm32/(commit log)

2025-05-02 Conmutacion asincronica
    [prueba_ocd.cfg]
2025-06-03 funciona ok, persiste problema de cambio de velocidad grande
    [motor_control.c]
2025-06-03 interesante implementacion, funciona de forma mas solida
2025-06-03 mejor lectura de codigo
2025-06-28 excelente, mejora SUSTANCIAL en maquina de estados
2025-07-01 buf!! ahora definitivo es el piola
2025-07-03 FINAL!! gracias aficion!! esto es para vosotros, SIIUUUU
2025-09-04 limpieza de archivos basura
    [New_configuration.cfg, prueba_ocd.cfg, prueba_open Debug.cfg]
2025-09-04 LICENSE
    Actualización de licencia.
2025-09-04 readme update
    Pequeño readme. Obviamente falta documentación, es para no dejarlo vacio.
2025-09-05 proceso de reestructuracion, creacion de carpetas
2025-09-19 fix headers mal hubicados y error de compilacion
    [comm.c, comm.h, firmware_esc_bldc_v1.ioc, flash_config.h, main.c]
2025-09-21 big refactor, separacion sustancial del modulo motor_control, se separo en bldc_driver y speed_sensor, haciendo que motor control sea una interfaz con los callbacks de interrupcion.
2025-09-21 correcion al ultimo refactor, no compilaba, add process_phase_measuremetn a la api de speed_sensor. compila
2026-06-18 GUI
    me olvide de commitear
2026-06-18 modifiaciones para simulacion PIL
2026-07-08 no mejoré el stall
    [comm_protocol.c, motor_control.c, motor_control.h]
2026-07-09 feat(simulation): commutate BLDC from rotor position
2026-07-10 fix(simulink): swap B and C phases in six-step commutator to correct rotation direction
    Invert the commutation sequence from ABC to ACB by swapping B and C
    phase assignments in all six Dsw patterns. This reverses the rotating
    magnetic field direction to match the Simscape BLDC block convention.
2026-07-10 fix(bridge): reduce HIL output poll period from 100ms to 20ms
    Match the 50 Hz Simulink sample rate so HIL_GET_OUTPUTS never returns
    data older than 20 ms, cutting maximum MCU-duty staleness from ~100 ms
    to ~20 ms in the UDP bridge response.
2026-07-10 fix(simulink): set fixed-step 20ms solver to align with bridge poll rate
    Change solver from VariableStepAuto to FixedStepAuto with 0.02 s
    fixed step, matching the HIL UDP bridge output poll period. This
    ensures Simulink and the bridge run on the same time base for
    coherent HIL/PIL frames. Update configure_hil_udp_receive.m to set
    the solver on model regeneration.
2026-07-10 fix(simulink): align Ideal Six-Step Commutator sample time to 20ms
    Change commutator SystemSampleTime from 1ms to 20ms (hilSampleTime)
    to match the fixed-step solver and all other HIL/UDP blocks.
    Update configure_hil_udp_receive.m to use the variable instead of
    a hardcoded 1e-3. Add autogenerated Simulink backup files to .gitignore.
2026-07-10 Revert "fix(simulink): align Ideal Six-Step Commutator sample time to 20ms"
    This reverts commit c5abbf2df89f87fcc10bb35cb83e8fbd94fb9bb5.
2026-07-10 feat(bridge): add traceable HIL validation replay
2026-07-11 fix(gui): reflect connection state in sidebar status led
2026-07-11 fix(gui): render error page outside interactive Blazor circuit
2026-07-11 feat(gui): add loading states and initial device scan
2026-07-13 docs(simulink): document offline-only validation flow
2026-07-15 chore(workflow): establish GitHub Flow (#7)
    ## Summary
    - Establish `main` as the only long-lived branch with short-lived typed
    branches and squash-only pull requests.
    - Document Conventional Commits, scoped SSD criteria, required checks,
    release rules, and emergency bypass policy.
    - Add a pull request template and align agent, SSD, README, and CI/CD
    guidance.
    - Reactivate weekly grouped Dependabot updates and remove the retired
    `pil_simul` CI target.
    - Apply matching GitHub settings for protected `main`, linear history,
    squash titles, and automatic branch deletion.
    ## Validation
    - [x] YAML parsed successfully with `js-yaml`.
    - [x] New Markdown passed `prettier --check`.
    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
2026-07-16 feat: improve ESC restart and speed monitoring
    - reset TIM4, PI, and speed-sensor runtime state so RUN works after STOP
    - add an interactive speed scope with cursors, transient measurements,
    CSV export, and buffer clearing
    - parse decimal controller gains invariantly and bind setpoint controls
    to active firmware speed limits
    - firmware Release build: 37,184 bytes FLASH (56.74%)
    - GUI tests: 43 passed
    - GUI Debug build: 0 warnings, 0 errors
    - Windows win-x64 publish completed
    ## Notes
    - firmware Debug compiles all objects but exceeds the 64 KiB FLASH
    region by 1,180 bytes under -O0
    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
    [motor_control.c, motor_control.h, speed_sensor.c, speed_sensor.h, startup.c]
2026-08-05 un poco de control y sistemas
    reflexiones y estado actual del proyecto
2026-08-05 some updates
    [agitador.3mf, barra_agitador_cap.SLDPRT, barra_agitador_cap.STEP, barra_agitadora.SLDASM, barra_agitadora_1.SLDPRT, barra_agitadora_1.STEP, base_agitador.SLDPRT, base_agitador.STEP]
2026-08-07 feat(esc): add configurable three-phase sine control
2026-08-08 lazo abierto sin para pruebas y arranque mejorado
    no entiendo como no hice esto con el arranque antes...quizá no sirva para el agitador pero si como ESC puro.
2026-08-10 feat(esc): add configurable BEMF blanking and current charts
    ## Qué cambia
    - agrega blanking BEMF configurable y persistente, con migración de
    configuración flash a V4
    - coordina protocolo firmware/GUI y restricciones de
    actualización/guardado en IDLE
    - incorpora adquisición, análisis y gráfica simultánea de corrientes
    IU/IV
    - actualiza tests y documentación técnica
    ## Motivo
    Evitar conmutaciones falsas por transitorios postconmutación y facilitar
    el diagnóstico de las corrientes medidas desde la GUI.
    ## Validación
    - `cmake --preset Debug -DESC_BUILD_CODE_DOCS=OFF`
    - `cmake --build --preset Debug`
    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
2026-08-10 fix(ci): install newlib for ARM firmware builds
    - instala explícitamente `libnewlib-arm-none-eabi` en el job
    `firmware-debug`
    - aplica la misma dependencia al workflow de release
    ## Causa raíz
    Los workflows usan `apt-get --no-install-recommends`;
    `gcc-arm-none-eabi` sólo recomienda Newlib, por lo que el runner quedaba
    sin headers estándar como `stdio.h` y el firmware no podía compilar.
    ## Validación local
    - firmware Debug: configure + build correcto
    - firmware Release: configure + build correcto
    La validación definitiva es el job `firmware-debug` en Ubuntu.
    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
